zumdar/harmonic_content_code/README.md

# harmonic_content_code
code and software documentation for the Harmonic Content installation

this is the documentation for the interactive art installation

# teensy pinouts
TBD
