zumdar/harmonic_content_code/documentation_website/docs/Spring 2021 documentation/documentation.md

title:     documentation of the installation
desc:       quick glance at pictures of the build process
date:       2021/12/15
version:    2.0.0
template:   document
nav:        Spring 2021 Documentation>process photos and documentation
percent:    100
authors:    freakylamps@gmail.com

# Spring 2021 - ECE4873 capstone documentation 

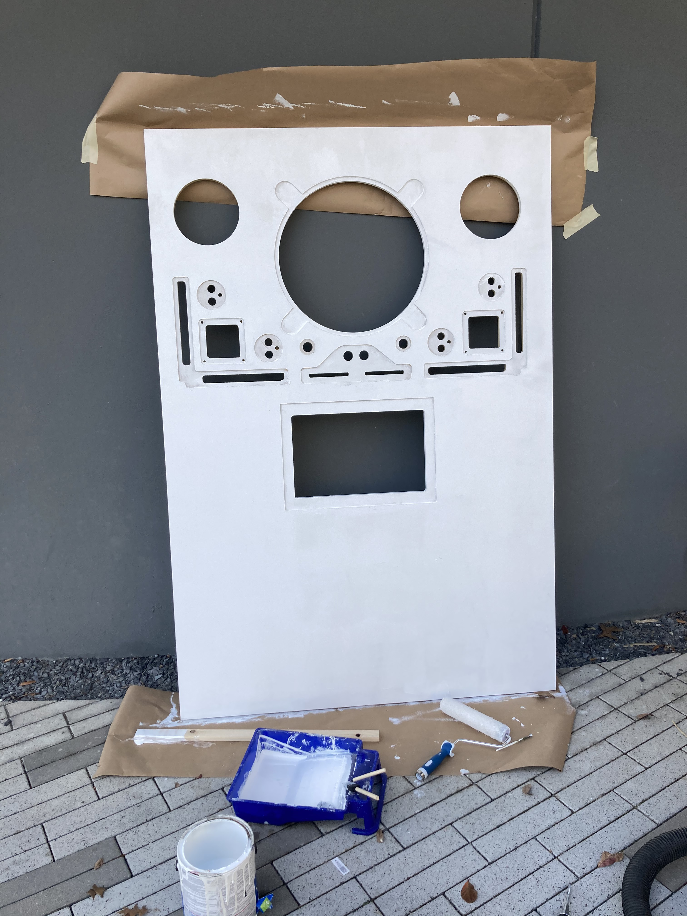
[picture p5: documentation_website/docs/Spring 2021 documentation/media/paintingPanel.jpg]

Here is CNC panel with a fresh coat of primer!
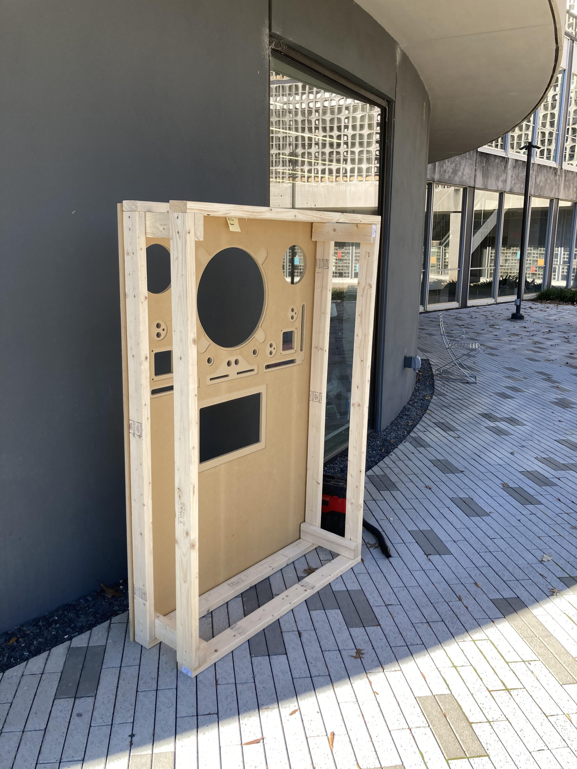
[picture p6: documentation_website/docs/Spring 2021 documentation/media/frameBuild.jpg]

About to attach the front panel to the frame

The assembled frame and panel

Mouting the synthesizer was the first step to bringing the installation to life!
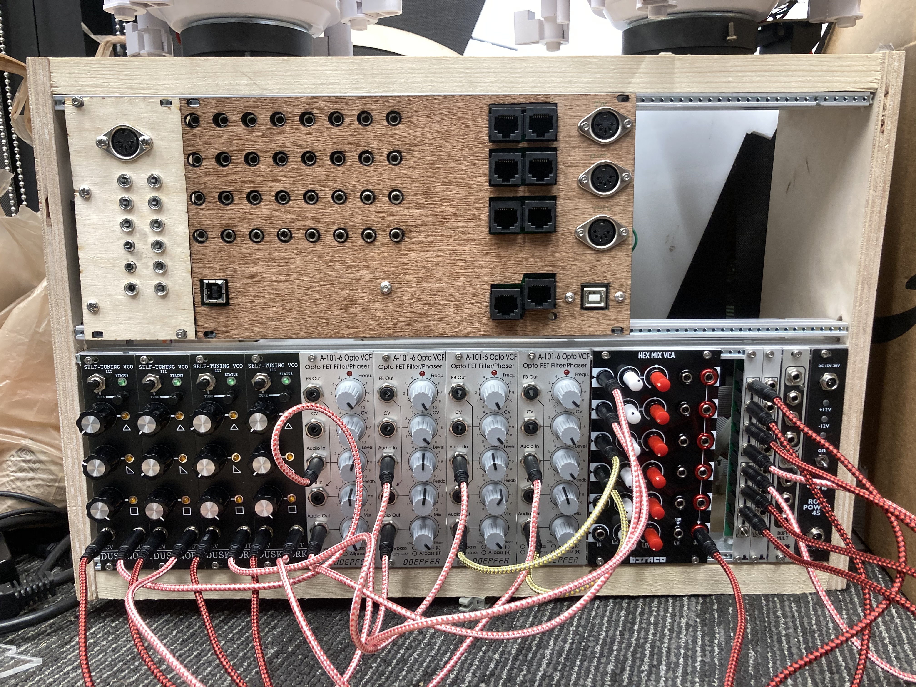
[picture p9: documentation_website/docs/Spring 2021 documentation/media/assembledSynth.jpg]

Closeup of the synth (before jacks were labelled)
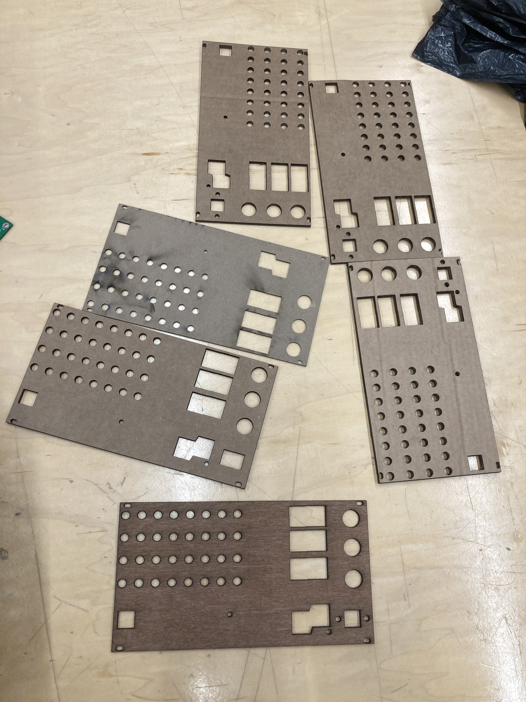
[picture p10: documentation_website/docs/Spring 2021 documentation/media/frontPanelDesigns.jpg]

This is how many panel laser cuts it took to get the PCB to fit perfectly to the front panel.

The wiring process has started

Going deeper with the wiring. Note the perf board on the right, that is a small board we with 4 MOSFETs so we can send a tuning signal out to the oscillators. 
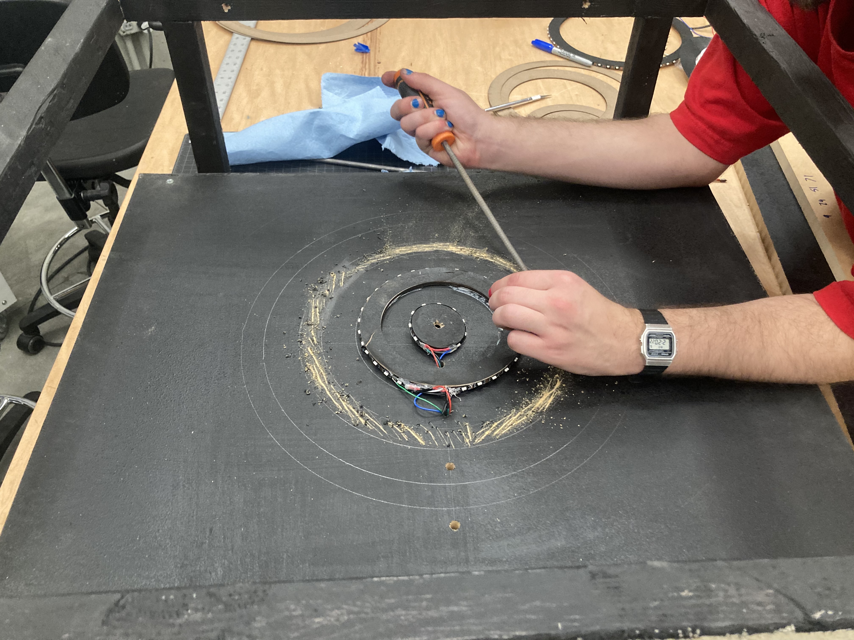
[picture p13: documentation_website/docs/Spring 2021 documentation/media/preppingLEDrings.jpg]

We had to do some scuffing up of the paint to get the LED rings to adhere to the back panel. 

ready to glue the LED rings to the panel!
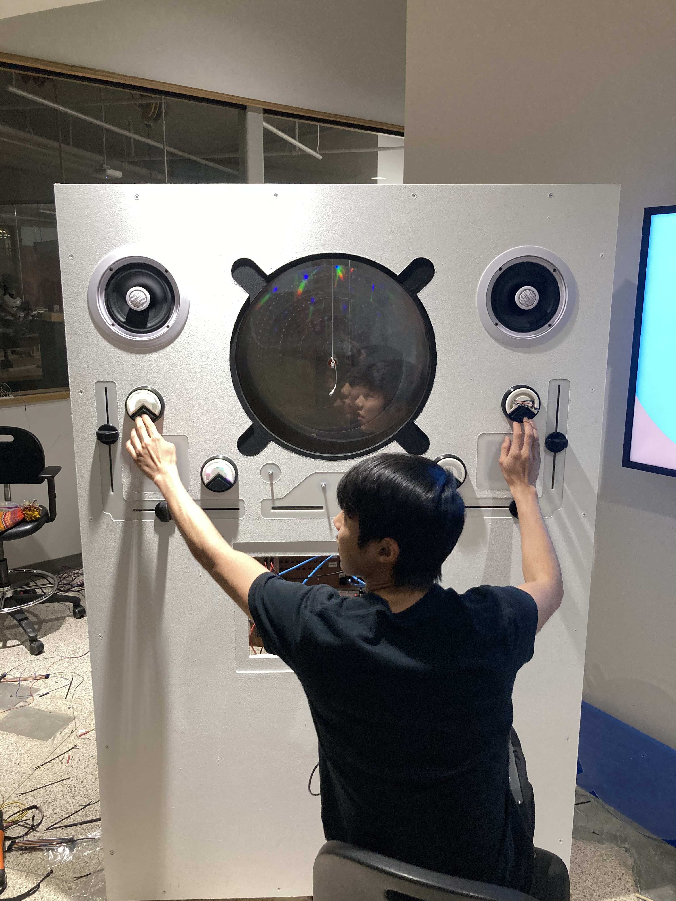
[picture p15: documentation_website/docs/Spring 2021 documentation/media/calibratingButtons.jpg]

Andrew is calibrating the buttons 

The installation is almost done!
