zumdar/harmonic_content_code/documentation_website/docs/Technical Documentation/media/Pasted image 20210310003054.png

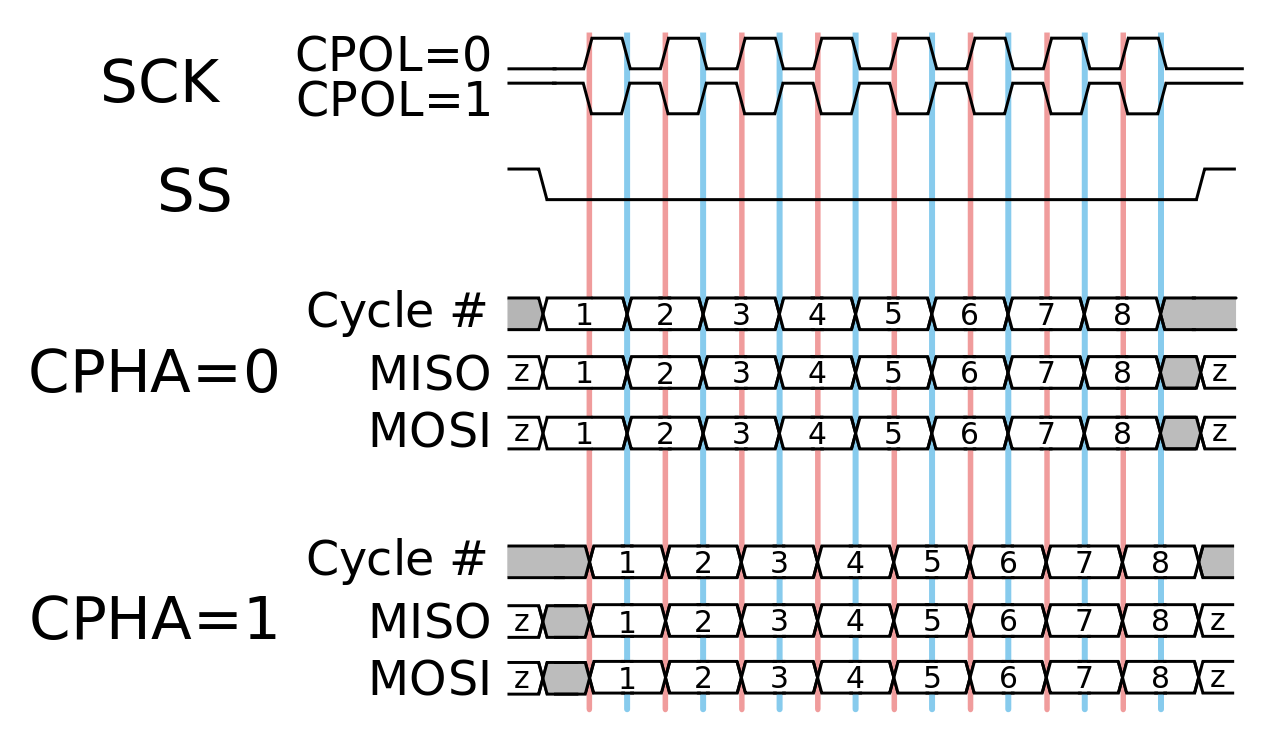
documentation_website/docs/Technical Documentation/media/Pasted image 20210310003054.png
