zumdar/harmonic_content_code/documentation_website/docs/Technical Documentation/media/Pasted image 20210311023916.png

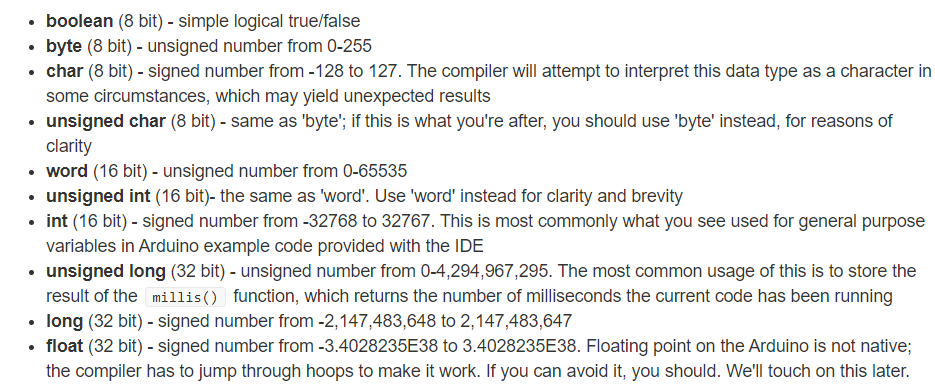
documentation_website/docs/Technical Documentation/media/Pasted image 20210311023916.png
