zumdar/harmonic_content_code/documentation_website/docs/Technical Documentation/media/Pasted image 20210318161513.png

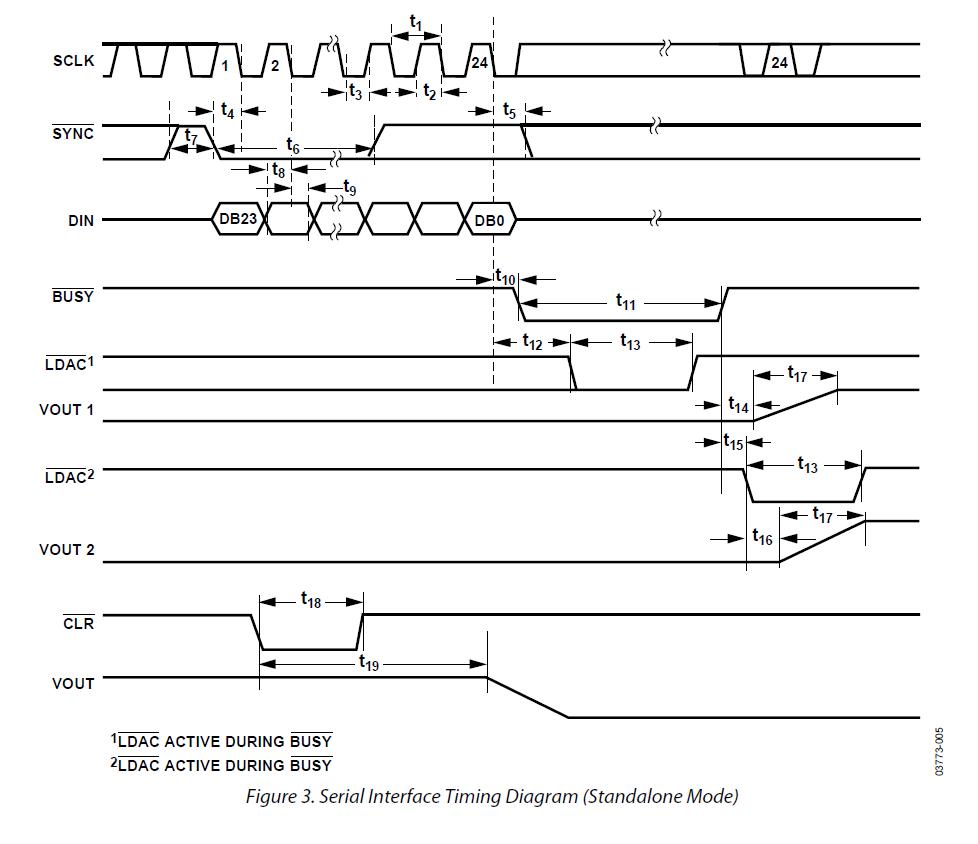
documentation_website/docs/Technical Documentation/media/Pasted image 20210318161513.png
