zumdar/harmonic_content_code/documentation_website/docs/Technical Documentation/media/Pasted image 20210324195648.png

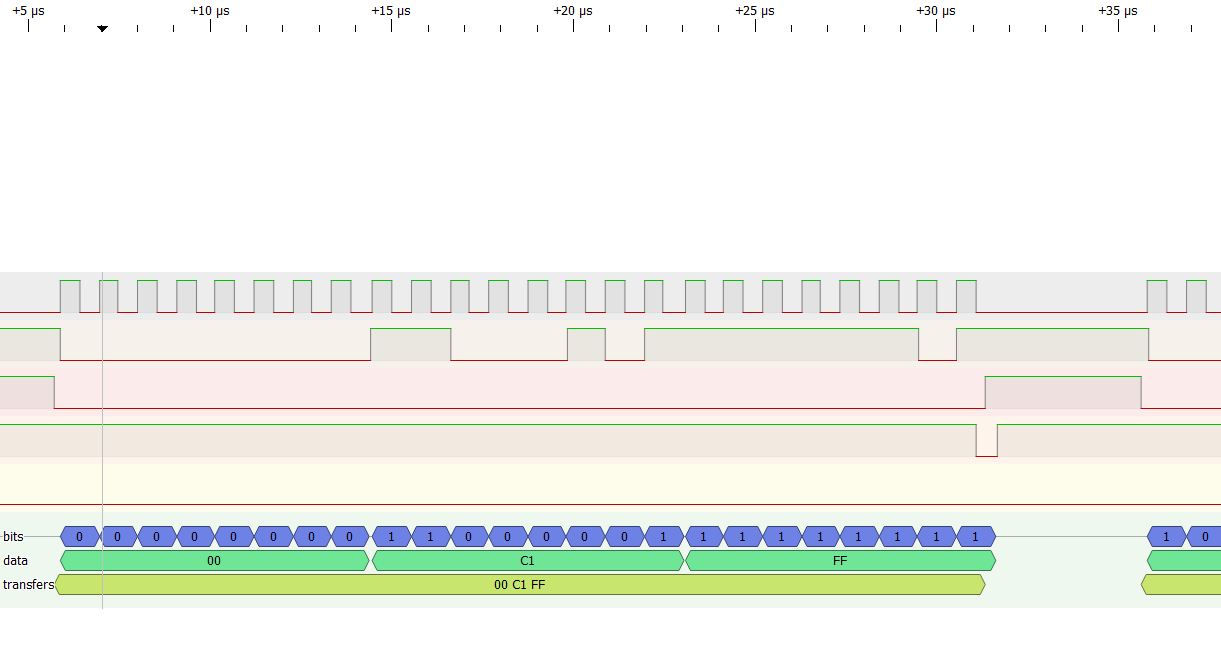
documentation_website/docs/Technical Documentation/media/Pasted image 20210324195648.png
