zumdar/harmonic_content_code/documentation_website/html_files/w/sd21f16Synth/sd21f16Synth/RIMG1157.JPG

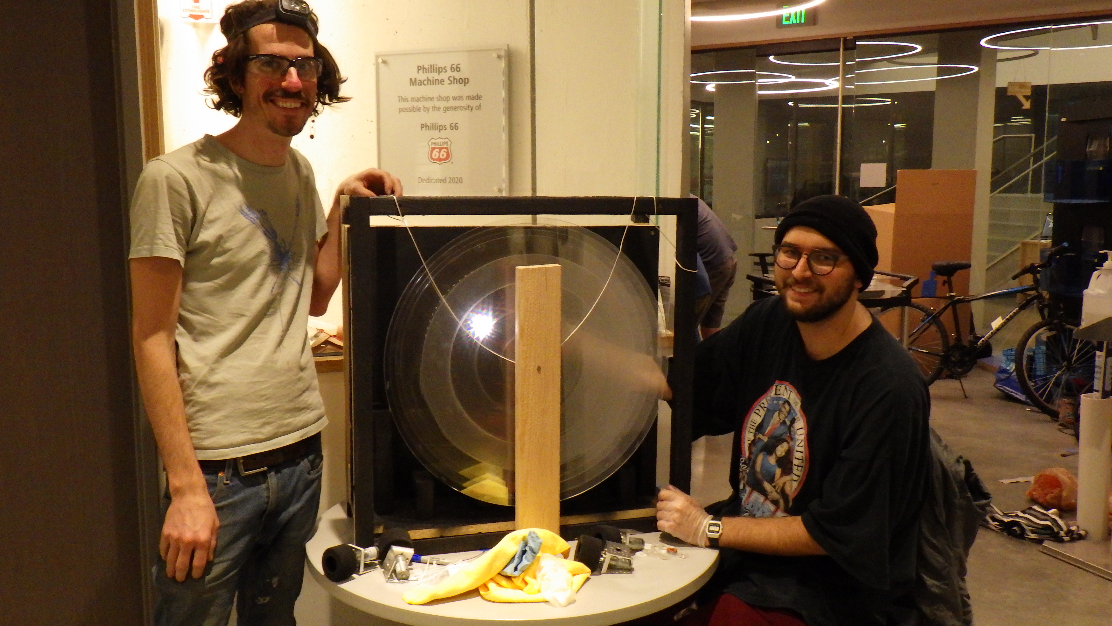
documentation_website/html_files/w/sd21f16Synth/sd21f16Synth/RIMG1157.JPG
