zumdar/harmonic_content_code/(threads)

Thread 1 (2021-10-06):

pcb desien

zumdar, 2021-10-06:
make main pcb with teensy and dac

zumdar, 2021-10-06:
12 - 10 v regulator
10v resistor matrix for input signals to teensy

Thread 3 (2021-10-06):

DAC - AD5370

zumdar, 2021-10-06:
https://www.analog.com/media/en/technical-documentation/evaluation-documentation/EVAL-AD5370_5372_5373EB.pdf

zumdar, 2021-10-22:
from the DAC datasheet:

The AD5370 has a high speed serial interface that is compatible
with SPI, QSPI™, MICROWIRE™, and DSP interface standards
and can handle clock speeds of up to 50 MHz.

The serial word (see Table 10) is 24 bits long; 16 of these bits are
data bits, six bits are address bits, and two bits are mode bits that
determine what is done with the data

24 bits per channel * 32 channels = 768 bits each update
50Mhz / 768 = 65k
theoretically we should be able to get a sampling frequency of 65 kHz

zumdar, 2021-11-03:
- run code with all channels working
- setup midi note to voltage outs (set up some kind of repeating sequencer thing)
- implement the envelopes

Thread 4 (2021-10-06):

self - tuning oscillator

zumdar, 2021-10-06:
use a relay to trigger the self tuing button
after button is triggered, send a C signal to tune
verify this works

Thread 5 (2021-10-06):

lighting and visuals pcbs

zumdar, 2021-10-06:
need signal going into teensy
need lighting going out of teensy
ws2815 - whatever the 12v addressable led is?

zumdar, 2021-12-01:
LEDS -
4 circles
4 buttons
4 sliders
190 leds total

circles
1 - 9 leds
2 - 28 leds
3- 31 leds
4-  74 leds

142 total

buttons
4x - 4 leds
16 total

sliders
4x - 8 leds
32 total
