zumdar/harmonic_content_code/jack_pcb/jack_pcb.kicad_pcb

## KiCad design jack_pcb/jack_pcb.kicad_pcb (2021-12-10)

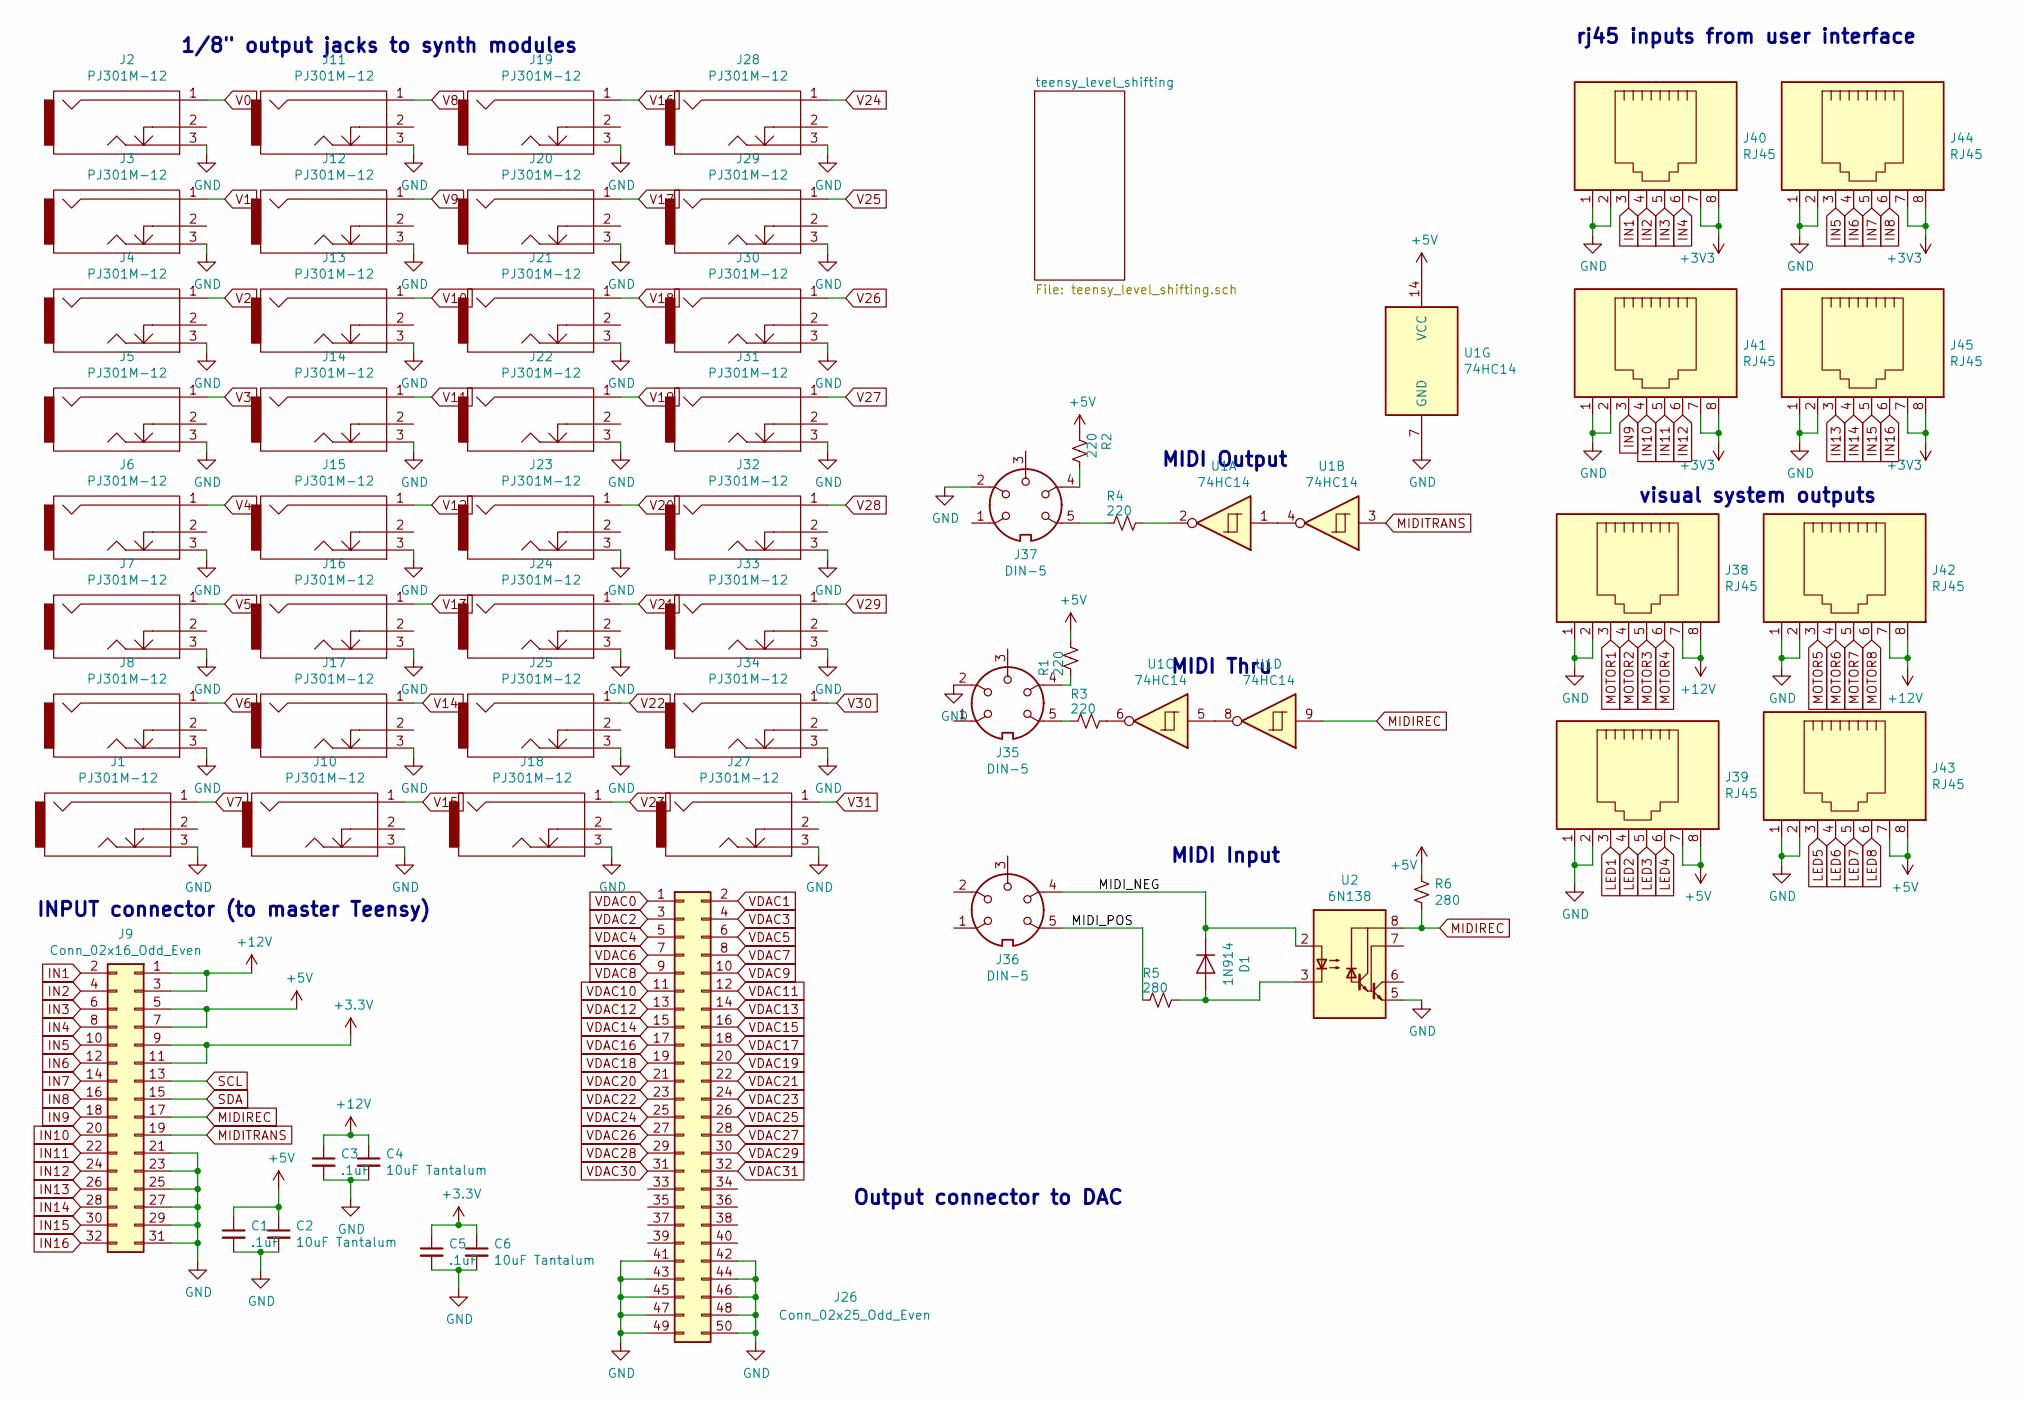
[picture p75: schematic jack_pcb.sch]

Parts:
C1, C3, C5: .1uF; C_Axial_L3.8mm_D2.6mm_P7.50mm_Horizontal
C2, C4, C6: 10uF Tantalum; C_Axial_L3.8mm_D2.6mm_P7.50mm_Horizontal
D1: 1N914; D_DO-35_SOD27_P7.62mm_Horizontal
J1, J2, J3, J4, J5, J6, J7, J8, J10, J11, J12, J13, J14, J15, J16, J17, J18, J19, J20, J21, J22, J23, J24, J25, J27, J28, J29, J30, J31, J32, J33, J34: PJ301M-12
J9: Conn_02x16_Odd_Even; PinSocket_2x16_P2.54mm_Vertical
J26: Conn_02x25_Odd_Even; PinSocket_2x25_P2.54mm_Vertical
J35, J36, J37: DIN-5; PinSocket_1x05_P2.54mm_Vertical
J38, J39, J40, J41, J42, J43, J44, J45: RJ45; RJ45_Amphenol_54602-x08_Horizontal
R1, R2, R3, R4: 220; R_Axial_DIN0207_L6.3mm_D2.5mm_P10.16mm_Horizontal
R5, R6: 280; R_Axial_DIN0207_L6.3mm_D2.5mm_P10.16mm_Horizontal
U1: 74HC14; DIP-14_W7.62mm_Socket_LongPads
U2: 6N138; DIP-8_W7.62mm_Socket

Connections:
+5V: C1.1, C2.1, J9.5, J9.7, J39.7, J39.8, J43.7, J43.8, R1.2, R2.1, R6.1, U1.14 (VCC); also elsewhere on the board
+12V: C3.1, C4.1, J9.1, J9.3, J38.7, J38.8, J42.7, J42.8
/MIDI_NEG: D1.1 (K), J36.4, U2.2 (C1)
/MIDI_POS: J36.5, R5.1
IN1: J9.2, J40.3
IN2: J9.4, J40.4
IN3: J9.6, J40.5
IN4: J9.8, J40.6
IN5: J9.10, J44.3
IN6: J9.12, J44.4
IN7: J9.14, J44.5
IN8: J9.16, J44.6
IN9: J9.18, J41.3
IN10: J9.20, J41.4
IN11: J9.22, J41.5
IN12: J9.24, J41.6
IN13: J9.26, J45.3
IN14: J9.28, J45.4
IN15: J9.30, J45.5
IN16: J9.32, J45.6
LED1: J39.3; also elsewhere on the board
LED2: J39.4; also elsewhere on the board
LED3: J39.5; also elsewhere on the board
LED4: J39.6; also elsewhere on the board
LED5: J43.3; also elsewhere on the board
LED6: J43.4; also elsewhere on the board
LED7: J43.5; also elsewhere on the board
LED8: J43.6; also elsewhere on the board
MIDIREC: J9.17, R6.2, U1.9, U2.8 (VCC)
MIDITRANS: J9.19, U1.3
MOTOR1: J38.3; also elsewhere on the board
MOTOR2: J38.4; also elsewhere on the board
MOTOR3: J38.5; also elsewhere on the board
MOTOR4: J38.6; also elsewhere on the board
MOTOR5: J42.3; also elsewhere on the board
MOTOR6: J42.4; also elsewhere on the board
MOTOR7: J42.5; also elsewhere on the board
MOTOR8: J42.6; also elsewhere on the board
unnamed: D1.2 (A), R5.2, U2.3 (C2)
unnamed: J35.4, R1.1
unnamed: J35.5, R3.1
unnamed: J37.4, R2.2
unnamed: J37.5, R4.1
unnamed: R3.2, U1.6
unnamed: R4.2, U1.2
unnamed: U1.1, U1.4
unnamed: U1.5, U1.8
SCL: J9.13; also elsewhere on the board
SDA: J9.15; also elsewhere on the board
V0: J2.1; also elsewhere on the board
V1: J3.1; also elsewhere on the board
V2: J4.1; also elsewhere on the board
V3: J5.1; also elsewhere on the board
V4: J6.1; also elsewhere on the board
V5: J7.1; also elsewhere on the board
V6: J8.1; also elsewhere on the board
V7: J1.1; also elsewhere on the board
V8: J11.1; also elsewhere on the board
V9: J12.1; also elsewhere on the board
V10: J13.1; also elsewhere on the board
V11: J14.1; also elsewhere on the board
V12: J15.1; also elsewhere on the board
V13: J16.1; also elsewhere on the board
V14: J17.1; also elsewhere on the board
V15: J10.1; also elsewhere on the board
V16: J19.1; also elsewhere on the board
V17: J20.1; also elsewhere on the board
V18: J21.1; also elsewhere on the board
V19: J22.1; also elsewhere on the board
V20: J23.1; also elsewhere on the board
V21: J24.1; also elsewhere on the board
V22: J25.1; also elsewhere on the board
V23: J18.1; also elsewhere on the board
V24: J28.1; also elsewhere on the board
V25: J29.1; also elsewhere on the board
V26: J30.1; also elsewhere on the board
V27: J31.1; also elsewhere on the board
V28: J32.1; also elsewhere on the board
V29: J33.1; also elsewhere on the board
V30: J34.1; also elsewhere on the board
V31: J27.1; also elsewhere on the board
VDAC0: J26.1; also elsewhere on the board
VDAC1: J26.2; also elsewhere on the board
VDAC2: J26.3; also elsewhere on the board
VDAC3: J26.4; also elsewhere on the board
VDAC4: J26.5; also elsewhere on the board
VDAC5: J26.6; also elsewhere on the board
VDAC6: J26.7; also elsewhere on the board
VDAC7: J26.8; also elsewhere on the board
VDAC8: J26.9; also elsewhere on the board
VDAC9: J26.10; also elsewhere on the board
VDAC10: J26.11; also elsewhere on the board
VDAC11: J26.12; also elsewhere on the board
VDAC12: J26.13; also elsewhere on the board
VDAC13: J26.14; also elsewhere on the board
VDAC14: J26.15; also elsewhere on the board
VDAC15: J26.16; also elsewhere on the board
VDAC16: J26.17; also elsewhere on the board
VDAC17: J26.18; also elsewhere on the board
VDAC18: J26.19; also elsewhere on the board
VDAC19: J26.20; also elsewhere on the board
VDAC20: J26.21; also elsewhere on the board
VDAC21: J26.22; also elsewhere on the board
VDAC22: J26.23; also elsewhere on the board
VDAC23: J26.24; also elsewhere on the board
VDAC24: J26.25; also elsewhere on the board
VDAC25: J26.26; also elsewhere on the board
VDAC26: J26.27; also elsewhere on the board
VDAC27: J26.28; also elsewhere on the board
VDAC28: J26.29; also elsewhere on the board
VDAC29: J26.30; also elsewhere on the board
VDAC30: J26.31; also elsewhere on the board
VDAC31: J26.32; also elsewhere on the board

Notes on the sheet:
1/8" output jacks to synth modules
rj45 inputs from user interface
visual system outputs
INPUT connector (to master Teensy)
MIDI Input
MIDI Output
MIDI Thru
Output connector to DAC

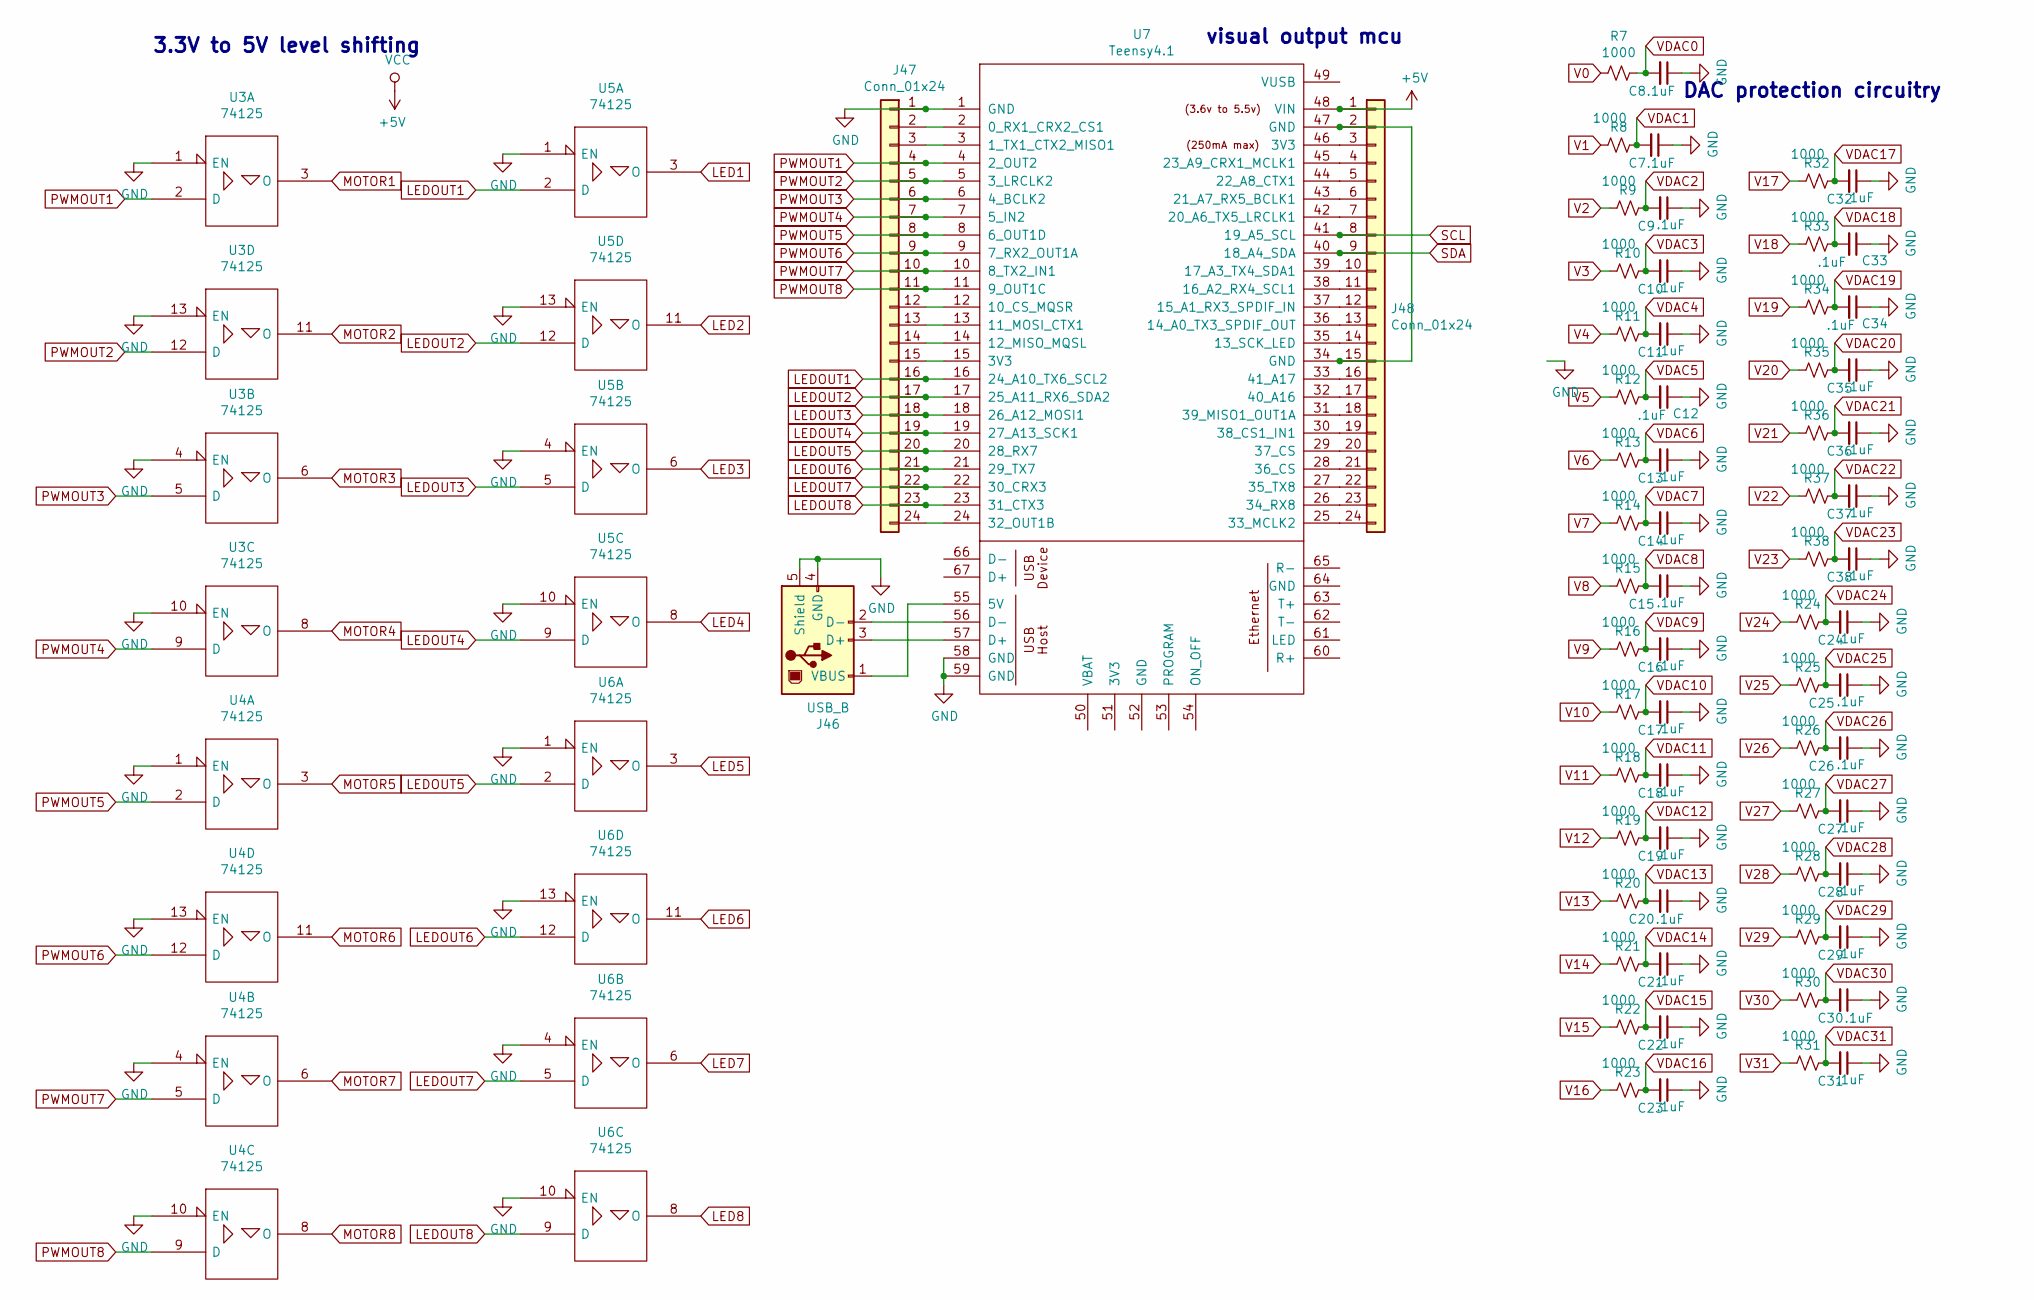
[picture p76: schematic teensy_level_shifting.sch]

Parts:
C7, C8, C9, C10, C11, C12, C13, C14, C15, C16, C17, C18, C19, C20, C21, C22, C23, C24, C25, C26, C27, C28, C29, C30, C31, C32, C33, C34, C35, C36, C37, C38: .1uF; C_Axial_L3.8mm_D2.6mm_P7.50mm_Horizontal
J46: USB_B; USB_B_TE_5787834_Vertical
J47, J48: Conn_01x24; PinHeader_1x24_P2.54mm_Vertical
R7, R8, R9, R10, R11, R12, R13, R14, R15, R16, R17, R18, R19, R20, R21, R22, R23, R24, R25, R26, R27, R28, R29, R30, R31, R32, R33, R34, R35, R36, R37, R38: 1000; R_Axial_DIN0207_L6.3mm_D2.5mm_P10.16mm_Horizontal
U3, U4, U5, U6: 74125; DIP-14_W7.62mm_Socket
U7: Teensy4.1; Teensy41

Connections:
+5V: J48.1, U3.14 (VCC), U4.14 (VCC), U5.14 (VCC), U6.14 (VCC), U7.48 (VIN); also elsewhere on the board
LED1: U5.3 (O); also elsewhere on the board
LED2: U5.11 (O); also elsewhere on the board
LED3: U5.6 (O); also elsewhere on the board
LED4: U5.8 (O); also elsewhere on the board
LED5: U6.3 (O); also elsewhere on the board
LED6: U6.11 (O); also elsewhere on the board
LED7: U6.6 (O); also elsewhere on the board
LED8: U6.8 (O); also elsewhere on the board
LEDOUT1: J47.16, U5.2 (D), U7.16 (24_A10_TX6_SCL2)
LEDOUT2: J47.17, U5.12 (D), U7.17 (25_A11_RX6_SDA2)
LEDOUT3: J47.18, U5.5 (D), U7.18 (26_A12_MOSI1)
LEDOUT4: J47.19, U5.9 (D), U7.19 (27_A13_SCK1)
LEDOUT5: J47.20, U6.2 (D), U7.20 (28_RX7)
LEDOUT6: J47.21, U6.12 (D), U7.21 (29_TX7)
LEDOUT7: J47.22, U6.5 (D), U7.22 (30_CRX3)
LEDOUT8: J47.23, U6.9 (D), U7.23 (31_CTX3)
MOTOR1: U3.3 (O); also elsewhere on the board
MOTOR2: U3.11 (O); also elsewhere on the board
MOTOR3: U3.6 (O); also elsewhere on the board
MOTOR4: U3.8 (O); also elsewhere on the board
MOTOR5: U4.3 (O); also elsewhere on the board
MOTOR6: U4.11 (O); also elsewhere on the board
MOTOR7: U4.6 (O); also elsewhere on the board
MOTOR8: U4.8 (O); also elsewhere on the board
unnamed: J46.1 (VBUS), U7.55 (5V)
unnamed: J46.2 (D-), U7.56 (D-)
unnamed: J46.3 (D+), U7.57 (D+)
unnamed: J47.2, U7.2 (0_RX1_CRX2_CS1)
unnamed: J47.3, U7.3 (1_TX1_CTX2_MISO1)
unnamed: J47.12, U7.12 (10_CS_MQSR)
unnamed: J47.13, U7.13 (11_MOSI_CTX1)
unnamed: J47.14, U7.14 (12_MISO_MQSL)
unnamed: J47.15, U7.15 (3V3)
unnamed: J47.24, U7.24 (32_OUT1B)
unnamed: J48.3, U7.46 (3V3)
unnamed: J48.4, U7.45 (23_A9_CRX1_MCLK1)
unnamed: J48.5, U7.44 (22_A8_CTX1)
unnamed: J48.6, U7.43 (21_A7_RX5_BCLK1)
unnamed: J48.7, U7.42 (20_A6_TX5_LRCLK1)
unnamed: J48.10, U7.39 (17_A3_TX4_SDA1)
unnamed: J48.11, U7.38 (16_A2_RX4_SCL1)
unnamed: J48.12, U7.37 (15_A1_RX3_SPDIF_IN)
unnamed: J48.13, U7.36 (14_A0_TX3_SPDIF_OUT)
unnamed: J48.14, U7.35 (13_SCK_LED)
unnamed: J48.16, U7.33 (41_A17)
unnamed: J48.17, U7.32 (40_A16)
unnamed: J48.18, U7.31 (39_MISO1_OUT1A)
unnamed: J48.19, U7.30 (38_CS1_IN1)
unnamed: J48.20, U7.29 (37_CS)
unnamed: J48.21, U7.28 (36_CS)
unnamed: J48.22, U7.27 (35_TX8)
unnamed: J48.23, U7.26 (34_RX8)
unnamed: J48.24, U7.25 (33_MCLK2)
PWMOUT1: J47.4, U3.2 (D), U7.4 (2_OUT2)
PWMOUT2: J47.5, U3.12 (D), U7.5 (3_LRCLK2)
PWMOUT3: J47.6, U3.5 (D), U7.6 (4_BCLK2)
PWMOUT4: J47.7, U3.9 (D), U7.7 (5_IN2)
PWMOUT5: J47.8, U4.2 (D), U7.8 (6_OUT1D)
PWMOUT6: J47.9, U4.12 (D), U7.9 (7_RX2_OUT1A)
PWMOUT7: J47.10, U4.5 (D), U7.10 (8_TX2_IN1)
PWMOUT8: J47.11, U4.9 (D), U7.11 (9_OUT1C)
SCL: J48.8, U7.41 (19_A5_SCL); also elsewhere on the board
SDA: J48.9, U7.40 (18_A4_SDA); also elsewhere on the board
V0: R7.2; also elsewhere on the board
V1: R8.1; also elsewhere on the board
V2: R9.1; also elsewhere on the board
V3: R10.1; also elsewhere on the board
V4: R11.1; also elsewhere on the board
V5: R12.1; also elsewhere on the board
V6: R13.1; also elsewhere on the board
V7: R14.1; also elsewhere on the board
V8: R15.1; also elsewhere on the board
V9: R16.1; also elsewhere on the board
V10: R17.1; also elsewhere on the board
V11: R18.1; also elsewhere on the board
V12: R19.1; also elsewhere on the board
V13: R20.1; also elsewhere on the board
V14: R21.1; also elsewhere on the board
V15: R22.1; also elsewhere on the board
V16: R23.1; also elsewhere on the board
V17: R32.1; also elsewhere on the board
V18: R33.1; also elsewhere on the board
V19: R34.1; also elsewhere on the board
V20: R35.1; also elsewhere on the board
V21: R36.1; also elsewhere on the board
V22: R37.1; also elsewhere on the board
V23: R38.1; also elsewhere on the board
V24: R24.1; also elsewhere on the board
V25: R25.1; also elsewhere on the board
V26: R26.1; also elsewhere on the board
V27: R27.1; also elsewhere on the board
V28: R28.1; also elsewhere on the board
V29: R29.1; also elsewhere on the board
V30: R30.1; also elsewhere on the board
V31: R31.1; also elsewhere on the board
VDAC0: C8.2, R7.1; also elsewhere on the board
VDAC1: C7.2, R8.2; also elsewhere on the board
VDAC2: C9.2, R9.2; also elsewhere on the board
VDAC3: C10.2, R10.2; also elsewhere on the board
VDAC4: C11.2, R11.2; also elsewhere on the board
VDAC5: C12.2, R12.2; also elsewhere on the board
VDAC6: C13.2, R13.2; also elsewhere on the board
VDAC7: C14.2, R14.2; also elsewhere on the board
VDAC8: C15.2, R15.2; also elsewhere on the board
VDAC9: C16.2, R16.2; also elsewhere on the board
VDAC10: C17.2, R17.2; also elsewhere on the board
VDAC11: C18.2, R18.2; also elsewhere on the board
VDAC12: C19.2, R19.2; also elsewhere on the board
VDAC13: C20.2, R20.2; also elsewhere on the board
VDAC14: C21.2, R21.2; also elsewhere on the board
VDAC15: C22.2, R22.2; also elsewhere on the board
VDAC16: C23.2, R23.2; also elsewhere on the board
VDAC17: C32.2, R32.2; also elsewhere on the board
VDAC18: C33.2, R33.2; also elsewhere on the board
VDAC19: C34.2, R34.2; also elsewhere on the board
VDAC20: C35.2, R35.2; also elsewhere on the board
VDAC21: C36.2, R36.2; also elsewhere on the board
VDAC22: C37.2, R37.2; also elsewhere on the board
VDAC23: C38.2, R38.2; also elsewhere on the board
VDAC24: C24.2, R24.2; also elsewhere on the board
VDAC25: C25.2, R25.2; also elsewhere on the board
VDAC26: C26.2, R26.2; also elsewhere on the board
VDAC27: C27.2, R27.2; also elsewhere on the board
VDAC28: C28.2, R28.2; also elsewhere on the board
VDAC29: C29.2, R29.2; also elsewhere on the board
VDAC30: C30.2, R30.2; also elsewhere on the board
VDAC31: C31.2, R31.2; also elsewhere on the board

Notes on the sheet:
visual output mcu
DAC protection circuitry
3.3V to 5V level shifting

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
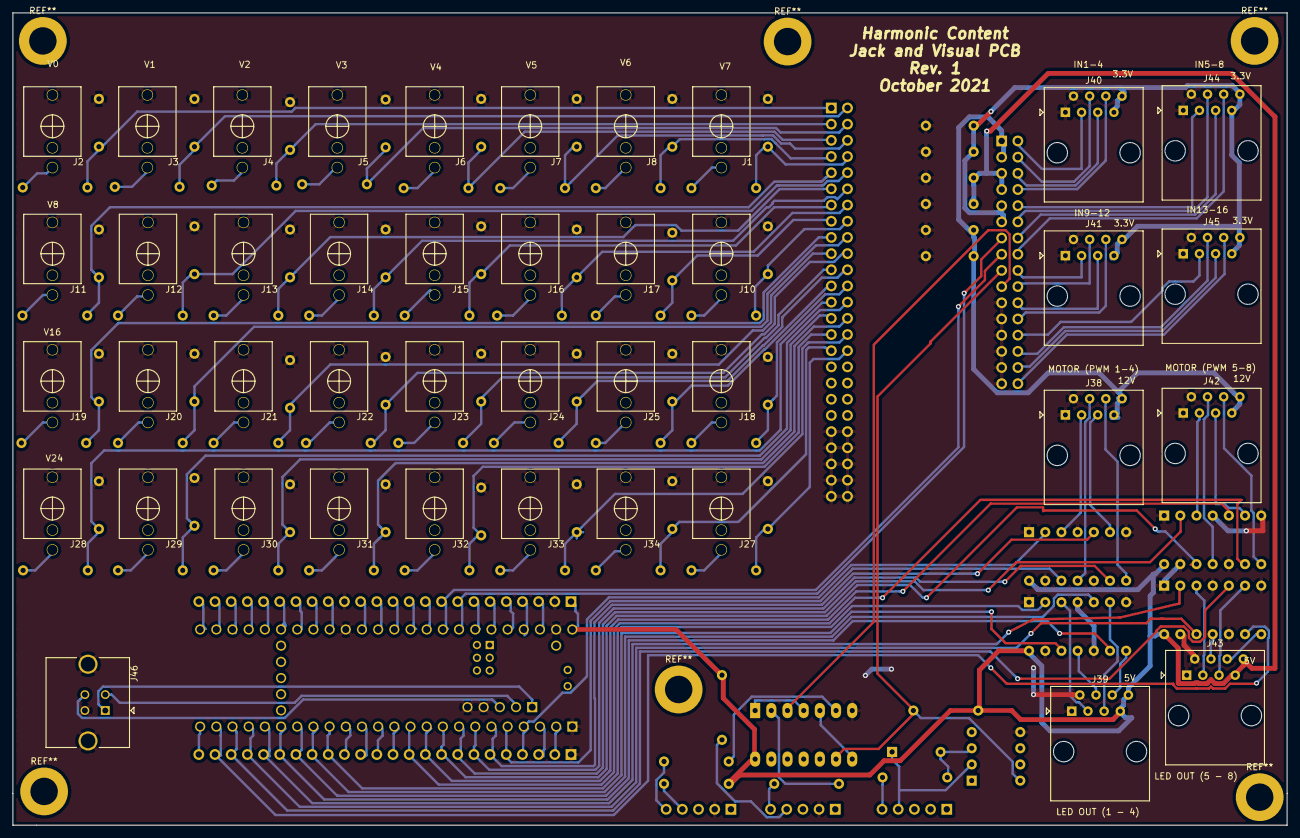
[picture p77: board jack_pcb.kicad_pcb from above]

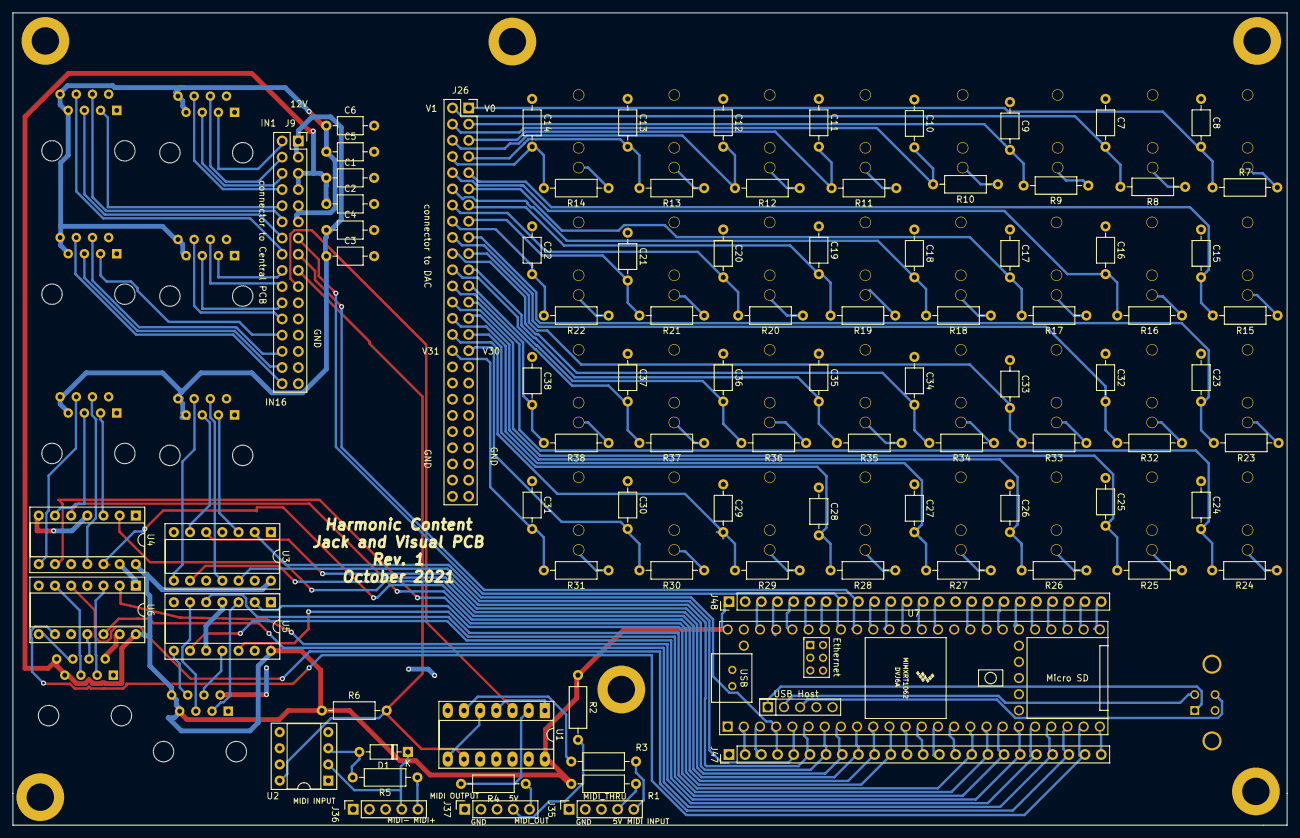
[picture p78: board jack_pcb.kicad_pcb from below]

Board: 2 copper layers, 200.0 x 127.5 mm, 132 parts (91 on the bottom side), 160 nets.
