zumdar/harmonic_content_code/CentralPCB/CentralPCB.kicad_pcb

## KiCad design CentralPCB/CentralPCB.kicad_pcb (2021-11-01)

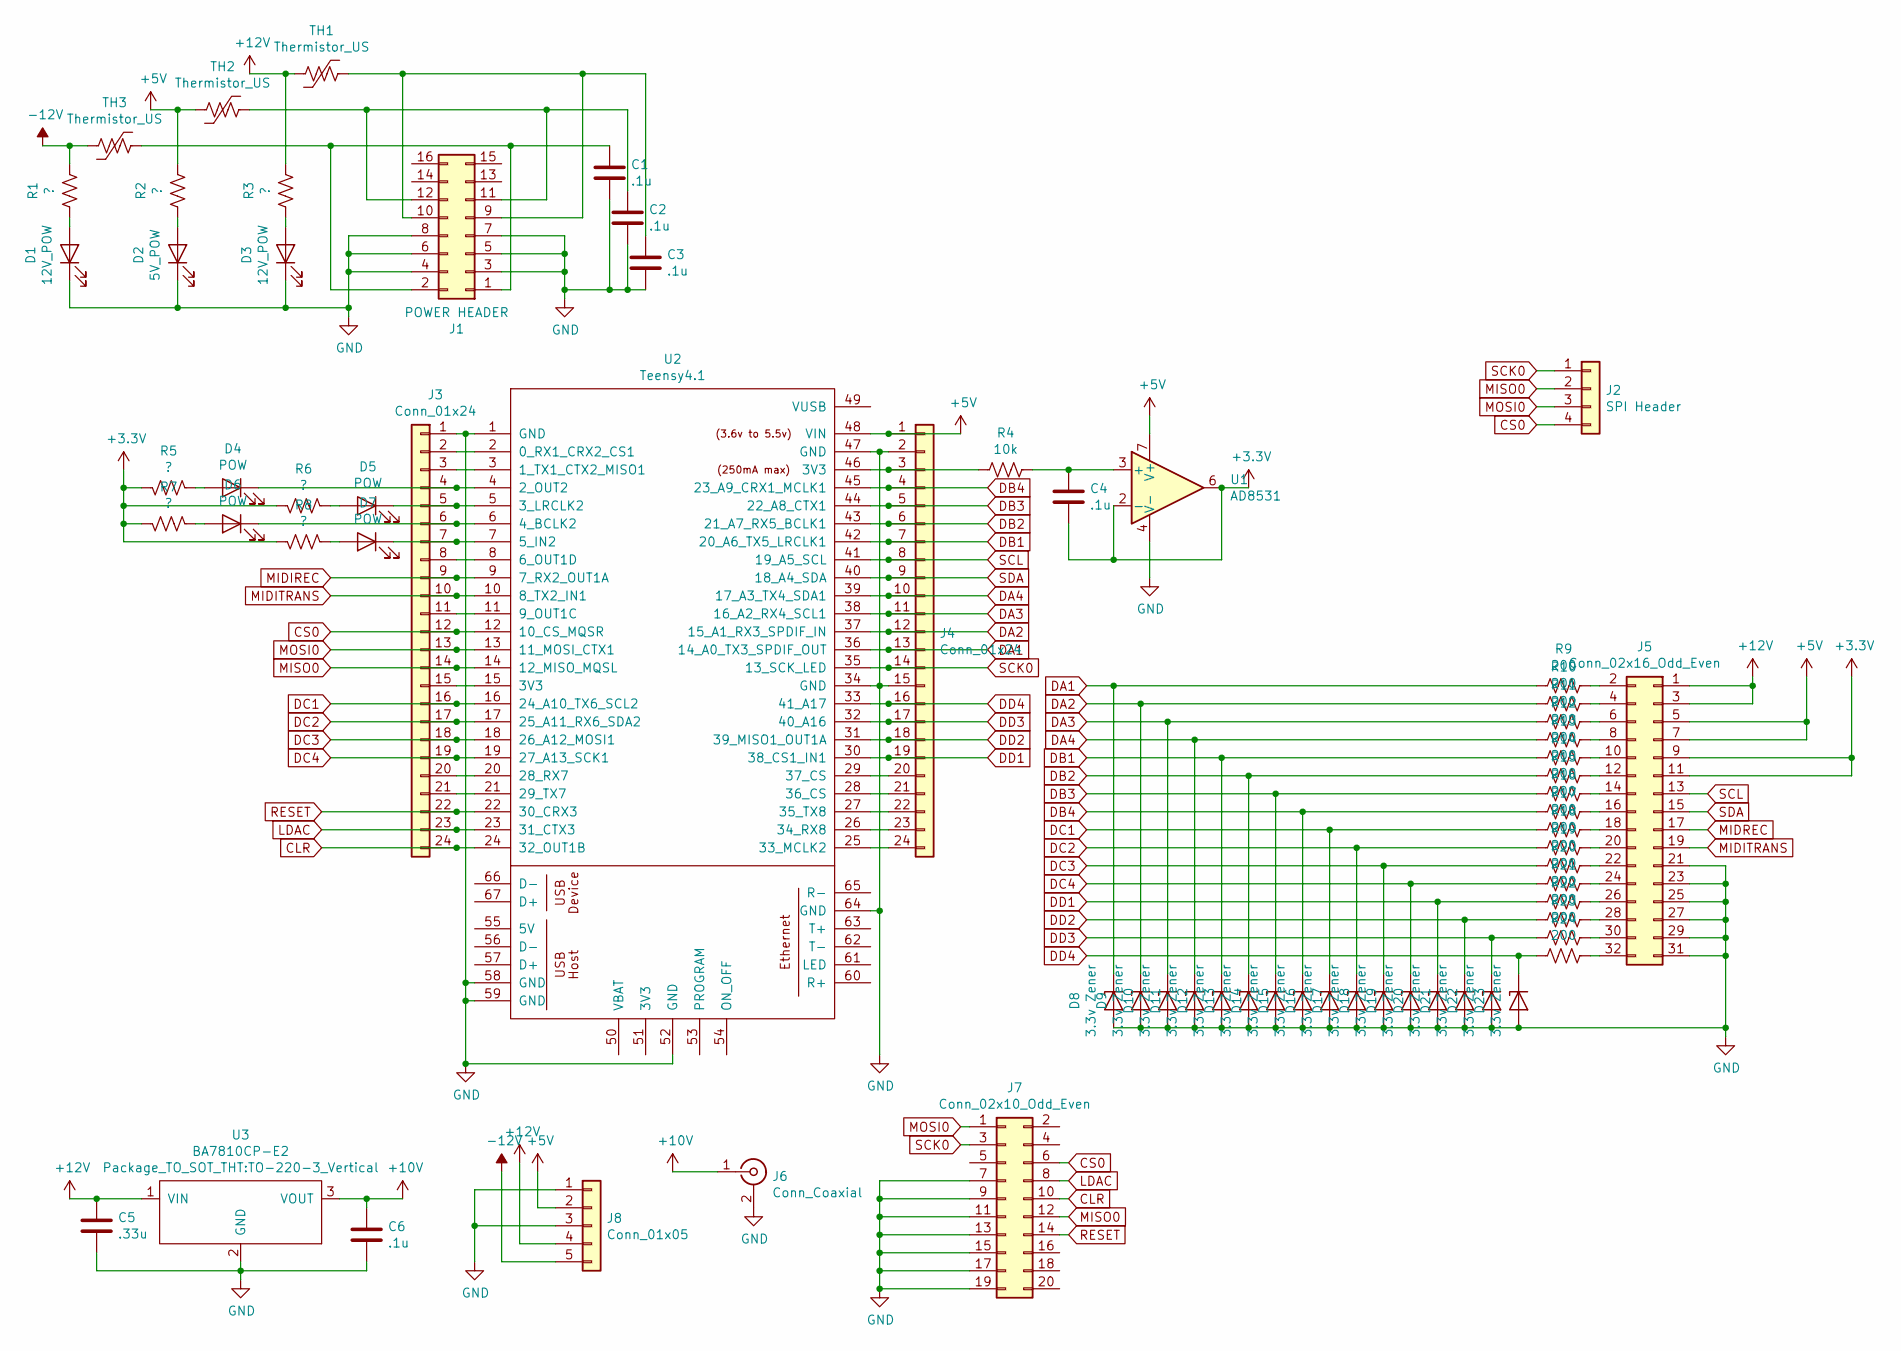
[picture p79: schematic CentralPCB.sch, Central Harmonic Content PCB]

Parts:
C1, C2, C3, C4, C6: .1u; C_0805_2012Metric
C5: .33u; C_0805_2012Metric
D1, D3: 12V_POW; LED_D3.0mm
D2: 5V_POW; LED_D3.0mm
D4, D5, D6, D7: POW; LED_D3.0mm
D8, D9, D10, D11, D12, D13, D14, D15, D16, D17, D18, D19, D20, D21, D22, D23: 3.3v Zener; D_SOD-123
J1: POWER HEADER; PinSocket_2x08_P2.54mm_Vertical
J2: SPI Header; PinSocket_1x04_P2.54mm_Vertical
J3, J4: Conn_01x24; PinSocket_1x24_P2.54mm_Vertical
J5: Conn_02x16_Odd_Even; PinSocket_2x16_P2.54mm_Vertical
J6: Conn_Coaxial; SMB_Jack_Vertical
J7: Conn_02x10_Odd_Even; PinSocket_2x10_P2.54mm_Vertical
J8: Conn_01x05; PhoenixContact_GMSTBVA-G_05x7.50mm_Vertical
R1, R2, R3, R5, R6, R7, R8: ?; R_0805_2012Metric
R4: 10k; R_0805_2012Metric
R9, R10, R11, R12, R13, R14, R15, R16, R17, R18, R19, R20, R21, R22, R23, R24: 200; R_0805_2012Metric
TH1, TH2, TH3: Thermistor_US; R_1206_3216Metric
U1: AD8531; SOIC-8_3.9x4.9mm_P1.27mm
U2: Teensy4.1; Teensy41
U3: BA7810CP-E2; TO-220-3_Vertical

Connections:
+3V3: C4.2, J5.9, J5.11, R5.1, R6.1, R7.1, R8.1, U1.2 (-), U1.6
+5V: J4.1, J5.5, J5.7, J8.2, R2.1, TH2.2, U1.7 (V+), U2.48 (VIN)
+10V: C6.1, J6.1 (In), U3.3 (VOUT)
+12V: C5.1, J5.1, J5.3, J8.4, R3.1, TH1.2, U3.1 (VIN)
-12V: J8.5, R1.1, TH3.2
CLR: J3.24, J7.10, U2.24 (32_OUT1B)
CS0: J2.4, J3.12, J7.6, U2.12 (10_CS_MQSR)
DA1: D8.1 (K), J4.13, R9.2, U2.36 (14_A0_TX3_SPDIF_OUT)
DA2: D9.1 (K), J4.12, R10.2, U2.37 (15_A1_RX3_SPDIF_IN)
DA3: D10.1 (K), J4.11, R11.2, U2.38 (16_A2_RX4_SCL1)
DA4: D11.1 (K), J4.10, R12.2, U2.39 (17_A3_TX4_SDA1)
DB1: D12.1 (K), J4.7, R13.2, U2.42 (20_A6_TX5_LRCLK1)
DB2: D13.1 (K), J4.6, R14.2, U2.43 (21_A7_RX5_BCLK1)
DB3: D14.1 (K), J4.5, R15.2, U2.44 (22_A8_CTX1)
DB4: D15.1 (K), J4.4, R16.2, U2.45 (23_A9_CRX1_MCLK1)
DC1: D16.1 (K), J3.16, R17.2, U2.16 (24_A10_TX6_SCL2)
DC2: D17.1 (K), J3.17, R18.2, U2.17 (25_A11_RX6_SDA2)
DC3: D18.1 (K), J3.18, R19.2, U2.18 (26_A12_MOSI1)
DC4: D19.1 (K), J3.19, R20.2, U2.19 (27_A13_SCK1)
DD1: D20.1 (K), J4.19, R21.2, U2.30 (38_CS1_IN1)
DD2: D21.1 (K), J4.18, R22.2, U2.31 (39_MISO1_OUT1A)
DD3: D22.1 (K), J4.17, R23.2, U2.32 (40_A16)
DD4: D23.1 (K), J4.16, R24.2, U2.33 (41_A17)
GND: C1.2, C2.2, C3.2, C5.2, C6.2, D1.1 (K), D2.1 (K), D3.1 (K), D8.2 (A), D9.2 (A), D10.2 (A), D11.2 (A), D12.2 (A), D13.2 (A), D14.2 (A), D15.2 (A), D16.2 (A), D17.2 (A), D18.2 (A), D19.2 (A), D20.2 (A), D21.2 (A), D22.2 (A), D23.2 (A), J1.3, J1.4, J1.5, J1.6, J1.7, J1.8, J3.1, J4.2, J4.15, J5.21, J5.23, J5.25, J5.27, J5.29, J5.31, J6.2 (Ext), J7.7, J7.9, J7.11, J7.13, J7.15, J7.17, J7.19, J8.1, J8.3, U1.4 (V-), U2.1 (GND), U2.34 (GND), U2.47 (GND), U2.52 (GND), U2.58 (GND), U2.59 (GND), U2.64 (GND), U3.2 (GND)
LDAC: J3.23, J7.8, U2.23 (31_CTX3)
MIDIREC: J3.9, U2.9 (7_RX2_OUT1A)
MIDITRANS: J3.10, J5.19, U2.10 (8_TX2_IN1)
MIDREC: J5.17
MISO0: J2.2, J3.14, J7.12, U2.14 (12_MISO_MQSL)
MOSI0: J2.3, J3.13, J7.1, U2.13 (11_MOSI_CTX1)
unnamed: C1.1, J1.1, J1.2, TH3.1
unnamed: C2.1, J1.11, J1.12, TH2.1
unnamed: C3.1, J1.9, J1.10, TH1.1
unnamed: C4.1, R4.1, U1.3 (+)
unnamed: D1.2 (A), R1.2
unnamed: D2.2 (A), R2.2
unnamed: D3.2 (A), R3.2
unnamed: D4.1 (K), J3.4, U2.4 (2_OUT2)
unnamed: D4.2 (A), R5.2
unnamed: D5.1 (K), J3.5, U2.5 (3_LRCLK2)
unnamed: D5.2 (A), R6.2
unnamed: D6.1 (K), J3.6, U2.6 (4_BCLK2)
unnamed: D6.2 (A), R7.2
unnamed: D7.1 (K), J3.7, U2.7 (5_IN2)
unnamed: D7.2 (A), R8.2
unnamed: J3.2, U2.2 (0_RX1_CRX2_CS1)
unnamed: J3.3, U2.3 (1_TX1_CTX2_MISO1)
unnamed: J3.8, U2.8 (6_OUT1D)
unnamed: J3.11, U2.11 (9_OUT1C)
unnamed: J3.15, U2.15 (3V3)
unnamed: J3.20, U2.20 (28_RX7)
unnamed: J3.21, U2.21 (29_TX7)
unnamed: J4.3, R4.2, U2.46 (3V3)
unnamed: J4.20, U2.29 (37_CS)
unnamed: J4.21, U2.28 (36_CS)
unnamed: J4.22, U2.27 (35_TX8)
unnamed: J4.23, U2.26 (34_RX8)
unnamed: J4.24, U2.25 (33_MCLK2)
unnamed: J5.2, R9.1
unnamed: J5.4, R10.1
unnamed: J5.6, R11.1
unnamed: J5.8, R12.1
unnamed: J5.10, R13.1
unnamed: J5.12, R14.1
unnamed: J5.14, R15.1
unnamed: J5.16, R16.1
unnamed: J5.18, R17.1
unnamed: J5.20, R18.1
unnamed: J5.22, R19.1
unnamed: J5.24, R20.1
unnamed: J5.26, R21.1
unnamed: J5.28, R22.1
unnamed: J5.30, R23.1
unnamed: J5.32, R24.1
RESET: J3.22, J7.14, U2.22 (30_CRX3)
SCK0: J2.1, J4.14, J7.3, U2.35 (13_SCK_LED)
SCL: J4.8, J5.13, U2.41 (19_A5_SCL)
SDA: J4.9, J5.15, U2.40 (18_A4_SDA)

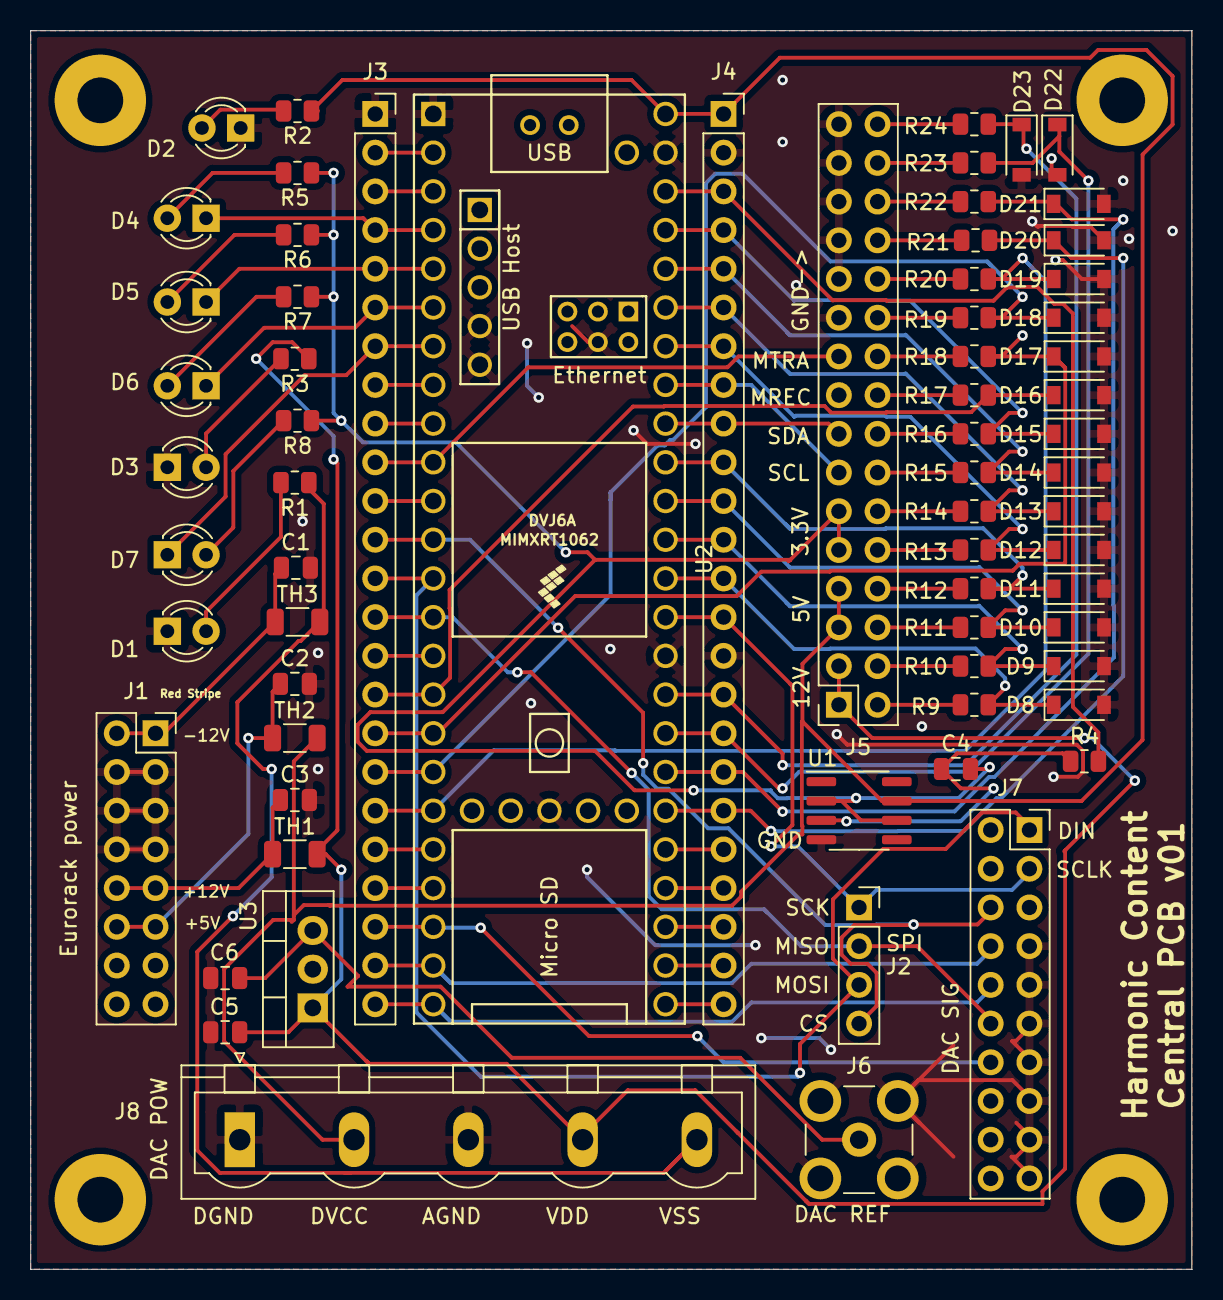
[picture p80: board CentralPCB.kicad_pcb from above]

Board: 2 copper layers, 76.2 x 81.3 mm, 71 parts (0 on the bottom side), 77 nets.

Other parts of the board:
 : MountingHole_3mm_Pad
 #2,  #3,  #4: MountingHole_3mm_Pad
