zumdar/harmonic_content_code/main/main.ino

#include <SPI.h>
#include <MIDI.h>
#include <Wire.h>

/*
 * References:
 * MIDI: https://www.pjrc.com/teensy/td_libs_MIDI.html
 * ADC: https://github.com/pedvide/ADC
 */

/*
 * Pinouts
 * 0    SPI_1 (CS)
 * 1    SPI_1 (MISO)
 * 2    power LED
 * 3    warning LED
 * 4    Error LED
 * 5    Comm LED (SPI)
 * 6    Tune button
 * 7    MIDI (Receive)
 * 8    MIDI (Transmit)
 * 9
 * 10   SPI_0 (CS)
 * 11   SPI_0 (MOSI)
 * 12   SPI_0 (MISO)
 * 13   SPI_0 (SCK)
 * 14   AnalogInput1 slider1 v 215-260
 * 15   AnalogInput2 button11 v
 * 16   AnalogInput3 button12 v
 * 17   AnalogInput4 slider2 20-700
 * 18   #AnalogInput5 sda
 * 19   #AnalogInput6 scl
 * 20   AnalogInput5 button21
 * 21   AnalogInput6 button22
 * 22   AnalogInput7 attack
 * 23   AnalogInput8
 * 24   AnalogInput9 slider3 200-1000
 * 25   AnalogInput10 button31
 * 26   AnalogInput11 button32
 * 27   AnalogInput12 slider4 20-700
 * 28   
 * 29
 * 30
 * 31
 * 32
 * 33   Tuner1
 * 34   Tuner2
 * 35   Tuner3
 * 36   Tuner4
 * 37
 * 38   AnalogInput13 button41 v
 * 39   AnalogInput14 button42 v
 * 40   AnalogInput15 releaseKnob v
 * 41   AnalogInput16
 */

//MIDI
MIDI_CREATE_INSTANCE(HardwareSerial, Serial1, MIDI);
#define HIGHEST_NOTE 48
#define LOWEST_NOTE 24
#define TUNE_NOTE 24
const int numNotes = HIGHEST_NOTE - LOWEST_NOTE;
const int noteStep = 1024/numNotes;

// SPI 0
const int CS0 = 10;
const int MISO0 = 12;
const int MOSI0 = 11;
const int SCK0 = 13;

// Analog Inputs
const int AnalogInputs[] = {16,21,26,39};//{15,16,20,21,25,26,38,39};
const int Button11 = 15;
const int Button12 = 16;
const int Button21 = 20;
const int Button22 = 21;
const int Button31 = 25;
const int Button32 = 26;
const int Button41 = 38;
const int Button42 = 39;
const int attackKnob = 22;
const int releaseKnob = 40;

//Outputs
const int tuner1 = 33;
const int tuner2 = 34;
const int tuner3 = 35;
const int tuner4 = 36;

int songNotes1[] = { 36, 43, 45, 48};
int songNotes2[] = { 36, 43, 45, 48};
int songNotes3[] = { 36, 43, 45, 48};
int songNotes4[] = { 36, 43, 45, 48};

//Private variables-----------------------------------------------------
enum state {
  idle,
  tune,
  play
};
int curr_state;
int inputTime;
int attackStep = 5;
int releaseStep = 5;
int prevNote[] = {24, 24, 24, 24};
int prevAmp[] = {0, 0, 0, 0};

//Private functions-----------------------------------------------------
/* Sends data to display
 * @param: oscil Oscillator number
 * @param: pitch Pitch level
 * @param: volume based on envelope
 * @return: None
 */
void sendI2C(int oscil, int pitch, int vol)
{
  Wire.beginTransmission(9); // transmit to device #4
  Wire.write("a");
  Wire.write(oscil); 
  Wire.write(":");
  Wire.write(pitch); 
  Wire.write(":");
  Wire.write(vol); 
  Wire.endTransmission();    // stop transmitting
}

/* Plays Note and keeps track of current envelope
 * @param: note Note Number MIDI
 * @param: oscillator Oscillator number
 * @return: None
 */
void playNote(int note, int oscillator)
{
  static int iteration = 0;
  //If note being played
  if(note >= 24)
  {
    if(note != prevNote[oscillator])
    {
      MIDI.sendNoteOn(note, 100, oscillator+1);
      prevNote[oscillator] = note;
    }
    //Attack
    if (prevAmp[oscillator] < 120)
    {
      prevAmp[oscillator] += attackStep;
      if(prevAmp[oscillator] > 120)
        prevAmp[oscillator] = 120;
      switch(oscillator)
      {
        case 0:
          MIDI.sendControlChange(71, prevAmp[oscillator], 1);
          break;
        case 1:
          MIDI.sendControlChange(72, prevAmp[oscillator], 1);
          break;
        case 2:
          MIDI.sendControlChange(73, prevAmp[oscillator], 1);
          break;
        case 3:
          MIDI.sendControlChange(74, prevAmp[oscillator], 1);
          break;
      }
      delay(5);
    }
    else
      prevAmp[oscillator] = 120;
  }
  if (note < 24)
  {
    //Release
    if (prevAmp[oscillator] > 0)
    {
      prevAmp[oscillator] -= releaseStep;
      if(prevAmp[oscillator] < 0)
        prevAmp[oscillator] = 0;
      switch(oscillator)
      {
        case 0:
          MIDI.sendControlChange(71, prevAmp[oscillator], 1);
          break;
        case 1:
          MIDI.sendControlChange(72, prevAmp[oscillator], 1);
          break;
        case 2:
          MIDI.sendControlChange(73, prevAmp[oscillator], 1);
          break;
        case 3:
          MIDI.sendControlChange(74, prevAmp[oscillator], 1);
          break;
      }
      delay(5);
    }
    else
      prevAmp[oscillator] = 0;
  }
  iteration++;
  if (iteration == 40)
  {
    sendI2C(oscillator, prevNote[oscillator], prevAmp[oscillator]);
    iteration = 0;
  }
}
 
/*
 * tunes oscillators
 * @param: None
 * @return: None
 */
void tuneOscillators()
{
  MIDI.sendNoteOn(TUNE_NOTE, 100, 1);
  MIDI.sendNoteOn(TUNE_NOTE, 100, 2);
  MIDI.sendNoteOn(TUNE_NOTE, 100, 3);
  MIDI.sendNoteOn(TUNE_NOTE, 100, 4);
  digitalWrite(tuner1, HIGH);
  digitalWrite(tuner2, HIGH);
  digitalWrite(tuner3, HIGH);
  digitalWrite(tuner4, HIGH);
  delay(200);
  digitalWrite(tuner1, LOW);
  digitalWrite(tuner2, LOW);
  digitalWrite(tuner3, LOW);
  digitalWrite(tuner4, LOW);
  delay(15000); //30 second tuning time
  return;
}

/*
 * checks for user input
 * @param: None
 * @return: true if user input is detected, else false
 */
bool detectUserInput()
{
  for(int i = 0; i < 4; i++)
  {
    if(digitalRead(AnalogInputs[i])==LOW)
    {
      //Serial.print(i);
      return true;
    }
  }
  return false;
}

/*
 * Plays idle notes
 * @param: None
 * @return: None
 */
void idlePlay()
{
  static int noteIndex = 0;
  if (noteIndex == 3)
    noteIndex = 0;
  int startTime = millis();
  MIDI.sendNoteOn(songNotes1[noteIndex], 100, 1);
  MIDI.sendNoteOn(songNotes2[noteIndex], 100, 2);
  MIDI.sendNoteOn(songNotes3[noteIndex], 100, 3);
  MIDI.sendNoteOn(songNotes4[noteIndex], 100, 4);
  Serial.println(songNotes1[noteIndex]);
  while (millis() - startTime < 5000)
  {
    if (detectUserInput())
      return;
    delay(5);
  }
  MIDI.sendNoteOff(songNotes1[noteIndex], 100, 1);
  MIDI.sendNoteOff(songNotes2[noteIndex], 100, 2);
  MIDI.sendNoteOff(songNotes3[noteIndex], 100, 3);
  MIDI.sendNoteOff(songNotes4[noteIndex], 100, 4);
  while (millis() - startTime < 1000)
  {
    if (detectUserInput())
      return;
    delay(5);
  }
  noteIndex++;
  return;
}

/*
 * Plays user notes
 * @param: None
 * @return: None
 */
void userPlay()
{
  int val;
  if(digitalRead(Button12) == LOW)
  {
    int val = analogRead(14);
    int note = (val-450)/(680/numNotes) + LOWEST_NOTE;
    Serial.println(note);
    playNote(note, 0);
  }
  if(digitalRead(Button12) == HIGH)
  {
    playNote(0, 0);
  }
  
  if(digitalRead(Button22) == LOW)
  {
    val = analogRead(17);
    int note = (val-20)/(680/numNotes) + LOWEST_NOTE;
    Serial.println(note);
    playNote(note, 1);
  }
  if(digitalRead(Button22) == HIGH)
  {
    playNote(0, 1);
  }
  
  if(digitalRead(Button32) == LOW)
  {
    val = analogRead(24);
    int note = (val-200)/(800/numNotes) + LOWEST_NOTE;
    Serial.println(note);
    playNote(note, 2);
  }
  if(digitalRead(Button32) == HIGH)
  {
    playNote(0, 2);
  }
  
  if(digitalRead(Button42) == LOW)
  {
    val = analogRead(27);
    int note = (val-20)/(680/numNotes) + LOWEST_NOTE;
    //Serial.println(note);
    playNote(note, 3);
  }
  if(digitalRead(Button42) == HIGH)
  {
    playNote(0, 3);
  }
  return;
}

//Main Program-----------------------------------------------------------
void setup() {
  Serial.begin(9600);
  MIDI.begin(); //MIDI serial
  Wire.begin(); //I2C to visual Display

  //Input Setup
  pinMode(Button11, INPUT_PULLUP);
  pinMode(Button12, INPUT_PULLUP);
  pinMode(Button21, INPUT_PULLUP);
  pinMode(Button22, INPUT_PULLUP);
  pinMode(Button31, INPUT_PULLUP);
  pinMode(Button32, INPUT_PULLUP);
  pinMode(Button41, INPUT_PULLUP);
  pinMode(Button42, INPUT_PULLUP);  
 
  //Output Setup
  pinMode(tuner1, OUTPUT);
  pinMode(tuner2, OUTPUT);
  pinMode(tuner3, OUTPUT);
  pinMode(tuner4, OUTPUT);
  digitalWrite(tuner1, LOW);
  digitalWrite(tuner2, LOW);
  digitalWrite(tuner3, LOW);
  digitalWrite(tuner4, LOW);

  //State Machine
  curr_state = idle;
  MIDI.sendProgramChange(4, 1);
  MIDI.sendNoteOn(TUNE_NOTE, 100, 1);
  MIDI.sendNoteOn(TUNE_NOTE, 100, 2);
  MIDI.sendNoteOn(TUNE_NOTE, 100, 3);
  MIDI.sendNoteOn(TUNE_NOTE, 100, 4);
}

void loop() {
  attackStep = 5;//analogRead(attackKnob);
  releaseStep = 5; //analogRead(releaseKnob);
  
  //Serial.println(attackStep);
  //Serial.println(releaseStep);
  switch (curr_state) {
    case idle:
      if (!detectUserInput())
      {
        Serial.print("idle\n");
        MIDI.sendControlChange(71, 120, 1);
        MIDI.sendControlChange(72, 120, 1);
        MIDI.sendControlChange(73, 120, 1);
        MIDI.sendControlChange(74, 120, 1);
        idlePlay();
      }
      else
      {
        curr_state = play;
        prevAmp[0] = 0;
        prevAmp[1] = 0;
        prevAmp[2] = 0;
        prevAmp[3] = 0;
        MIDI.sendControlChange(71, 0, 1);
        MIDI.sendControlChange(72, 0, 1);
        MIDI.sendControlChange(73, 0, 1);
        MIDI.sendControlChange(74, 0, 1);
      }
      break;
      
    case tune:
      Serial.print("tune");
      tuneOscillators();
      delay(1000);
      curr_state = idle;
      break;
      
    case play:
      Serial.println("play");
      if (detectUserInput())
      {
        inputTime = millis();
      }
      if (millis() - inputTime > 300000)
      {
        curr_state = tune;
        break;
      }
      userPlay();
      break;
  }
  delay(10);
}
