zumdar/harmonic_content_code/(commit log)

2021-04-19 initial adds. code from fall 2019 and spring 2021
2021-10-05 first jack pcb
    [jack_pcb.kicad_pcb, jack_pcb.sch]
2021-10-05 jack pcb work
    [jack_pcb.sch]
2021-10-09 pin assignments
2021-10-09 Added CentralPCB board
    [CentralPCB.kicad_pcb, CentralPCB.sch]
2021-10-20 Updated user interface pins
    [CentralPCB.sch]
2021-10-20 Fixed diodes
    [CentralPCB.sch]
2021-10-22 PCB update
    [CentralPCB.sch]
2021-10-22 Fixed Teensy connections
    [CentralPCB.kicad_pcb, CentralPCB.sch]
2021-10-22 jack pcb update
    [jack_pcb.sch]
2021-10-22 Consolidated pin headers
    [CentralPCB.kicad_pcb, CentralPCB.sch]
2021-10-25 Updated DAC connections
    [CentralPCB.kicad_pcb, CentralPCB.sch]
2021-10-25 Pin updates
    [CentralPCB.kicad_pcb, CentralPCB.sch]
2021-10-25 small pcb changes
    [CentralPCB.sch]
2021-10-26 Changed phoenix connector
    [CentralPCB.kicad_pcb, CentralPCB.sch]
2021-10-26 -12v LED
    [CentralPCB.kicad_pcb, CentralPCB.sch]
2021-10-26 Revert "Sav"
    [CentralPCB.kicad_pcb, CentralPCB.sch]
2021-10-26 Squashed commit of the following:
    commit 4cc6f9daa43c8e58e4c19e3ea2c52996bd638c5b
    Author: SavHearn <sav.hearn@gmail.com>
    Date: Tue Oct 26 14:19:17 2021 -0400
    Auto generated file
    [CentralPCB.sch]
2021-10-26 Fixed glitched CentralPCB schematic
    [CentralPCB.sch]
2021-10-27 Began CentralPCB layout
    [CentralPCB.kicad_pcb, CentralPCB.sch]
2021-10-27 jack board updates
    [jack_pcb.sch]
2021-10-27 More routing CentralPCB
    [CentralPCB.kicad_pcb, CentralPCB.sch]
2021-10-29 Finished CentralPCB
    [CentralPCB.kicad_pcb, CentralPCB.sch]
2021-10-29 Added additional protection for CentralPCB
    [CentralPCB.kicad_pcb, CentralPCB.sch]
2021-10-30 jack board modifications
    [jack_pcb.kicad_pcb, jack_pcb.sch]
2021-10-30 small silkscreen changes on centralpcb
    [CentralPCB.kicad_pcb, CentralPCB.sch]
2021-10-31 finalized jack board
    [jack_pcb.kicad_pcb, jack_pcb.sch, teensy_level_shifting.sch]
2021-11-01 gerbers and small finalizations to boards
    [CentralPCB-B_Cu.gbl, CentralPCB-B_Mask.gbs, CentralPCB-B_Paste.gbp, CentralPCB-B_SilkS.gbo, CentralPCB-Edge_Cuts.gm1, CentralPCB-F_Cu.gtl, CentralPCB-F_Mask.gts, CentralPCB-F_Paste.gtp]
2021-11-26 I2C setup
2021-12-06 display driver
2021-12-10 adding website stuff
    [jack_pcb.csv, jack_pcb.kicad_pcb]
