zumdar/harmonic_content_code/documentation_website/docs/Spring 2021 documentation/media/frameBack.jpg

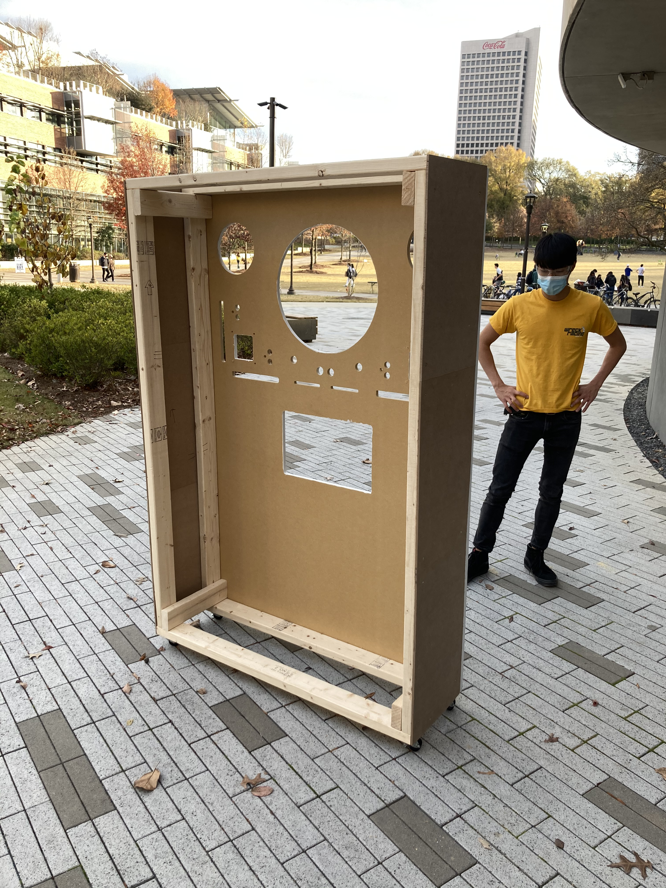
[picture p7: documentation_website/docs/Spring 2021 documentation/media/frameBack.jpg]
documentation_website/docs/Spring 2021 documentation/media/frameBack.jpg
