zumdar/harmonic_content_code/documentation_website/docs/Spring 2021 documentation/media/framewsynth.jpg

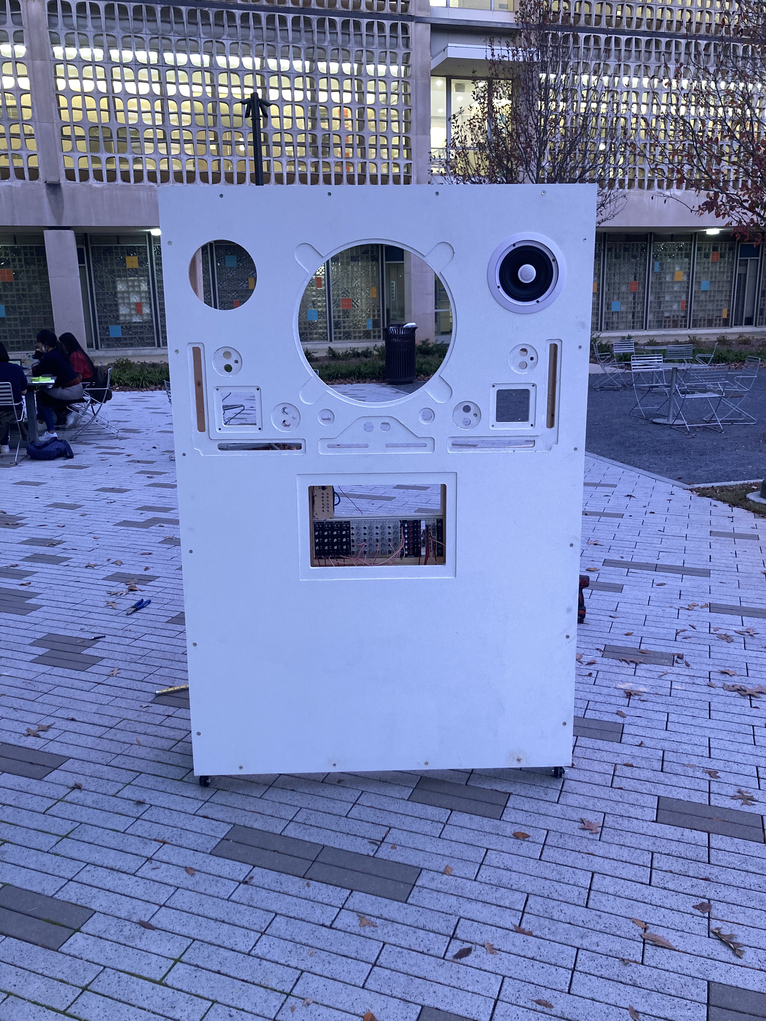
[picture p8: documentation_website/docs/Spring 2021 documentation/media/framewsynth.jpg]
documentation_website/docs/Spring 2021 documentation/media/framewsynth.jpg
