zumdar/harmonic_content_code/documentation_website/docs/Spring 2021 documentation/media/startingWiring.jpg

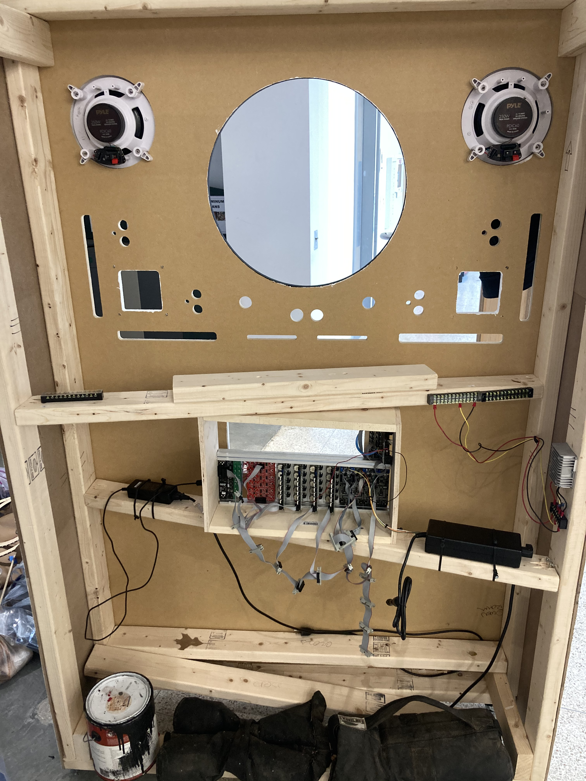
[picture p11: documentation_website/docs/Spring 2021 documentation/media/startingWiring.jpg]
documentation_website/docs/Spring 2021 documentation/media/startingWiring.jpg
