zumdar/harmonic_content_code/documentation_website/docs/Spring 2021 documentation/media/more_wiring.jpg

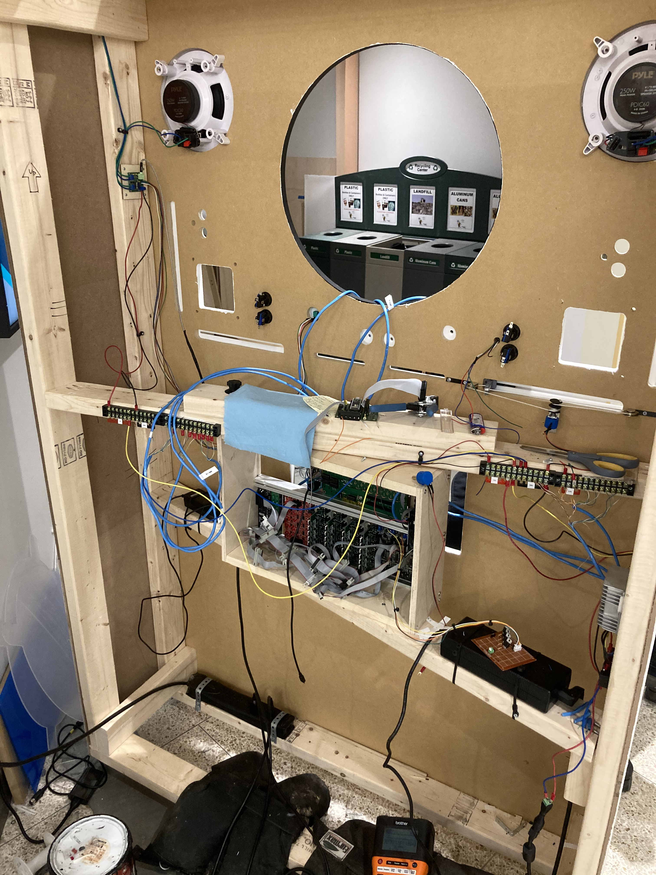
[picture p12: documentation_website/docs/Spring 2021 documentation/media/more_wiring.jpg]
documentation_website/docs/Spring 2021 documentation/media/more_wiring.jpg
