zumdar/harmonic_content_code/documentation_website/docs/Spring 2021 documentation/media/readyToGlue.jpg

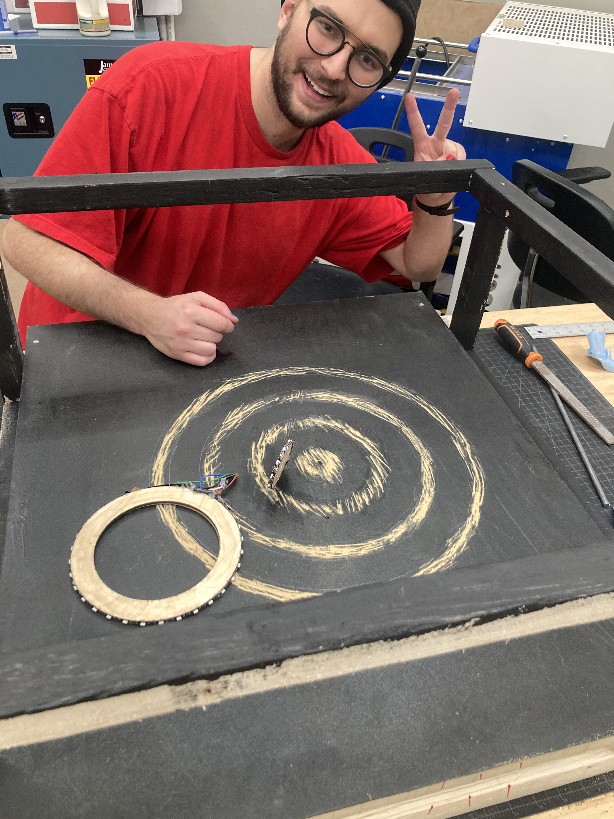
[picture p14: documentation_website/docs/Spring 2021 documentation/media/readyToGlue.jpg]
documentation_website/docs/Spring 2021 documentation/media/readyToGlue.jpg
