zumdar/harmonic_content_code/documentation_website/docs/Spring 2021 documentation/media/almostDone.jpg

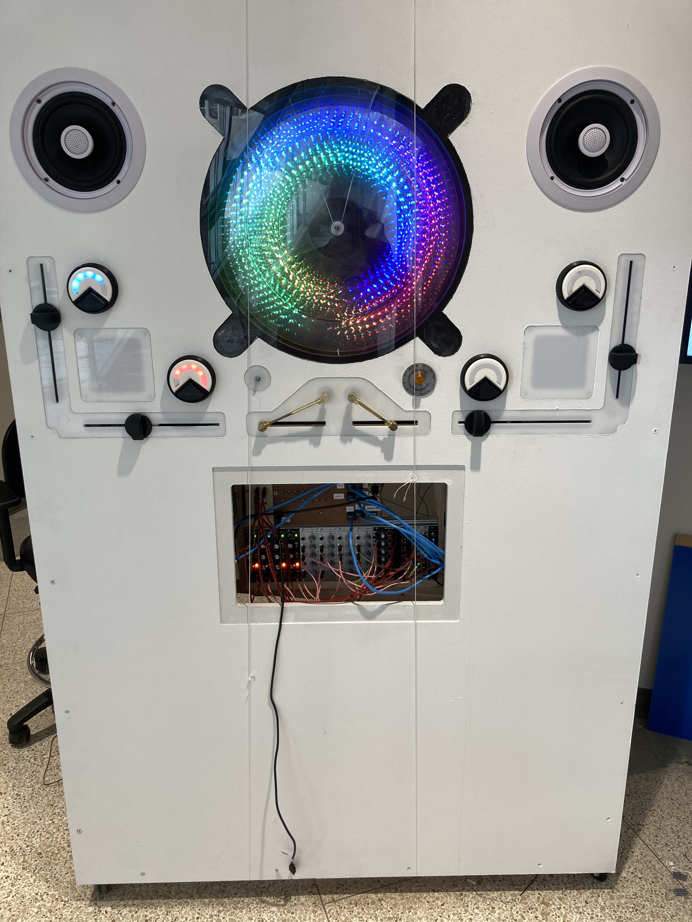
[picture p16: documentation_website/docs/Spring 2021 documentation/media/almostDone.jpg]
documentation_website/docs/Spring 2021 documentation/media/almostDone.jpg
