zumdar/harmonic_content_code/documentation_website/docs/Spring 2021 documentation/media/completedFrame.jpg

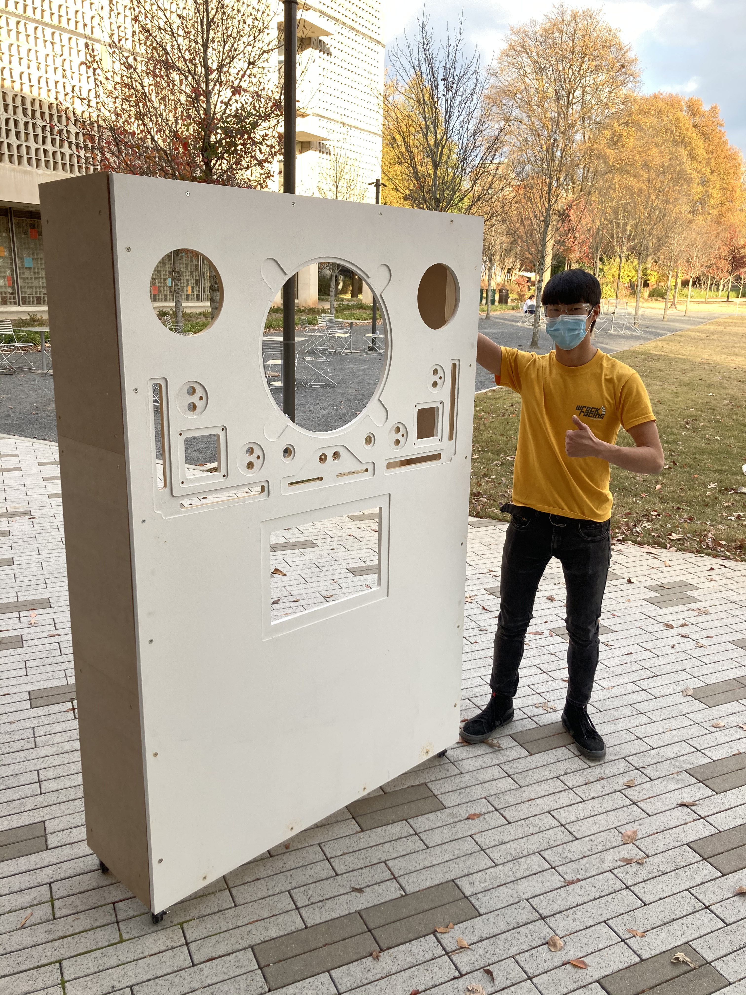
documentation_website/docs/Spring 2021 documentation/media/completedFrame.jpg
